Iva5858/juan_learns_to_walk/juan/assets/lm2596_regulator__5.stl

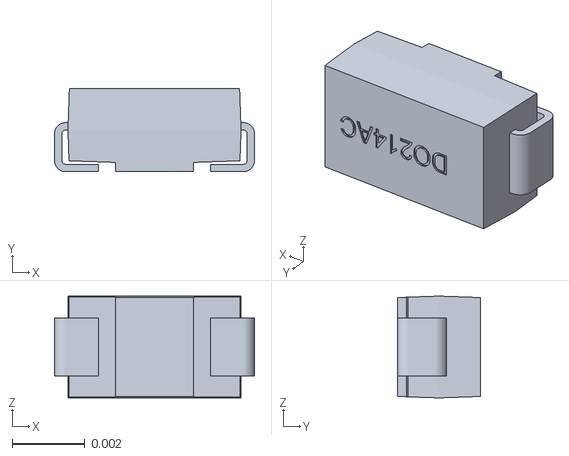
[picture p1: CAD file, 2026-10-11]
juan/assets/lm2596_regulator__5.stl
0.00549 x 0.00229 x 0.00279
