Iva5858/juan_learns_to_walk/juan/assets/9_head_cover.stl

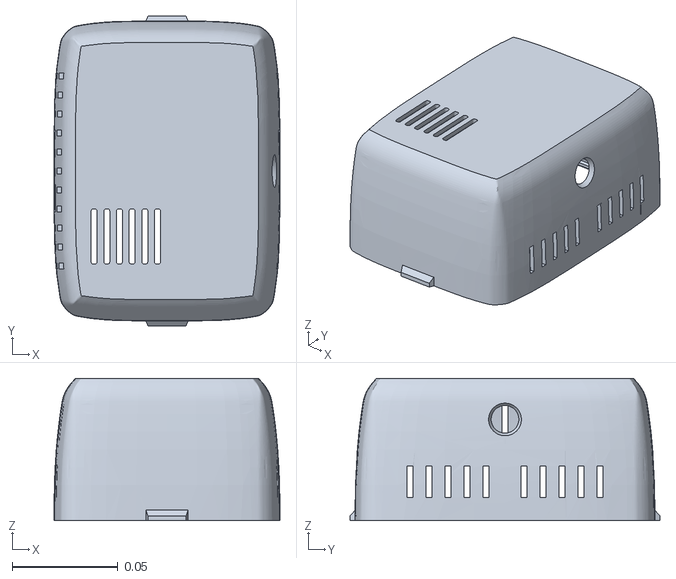
[picture p2: CAD file, 2026-10-11]
juan/assets/9_head_cover.stl
0.107 x 0.147 x 0.0674
