Iva5858/juan_learns_to_walk/juan/assets/adafruit_bno055_imu__81.stl

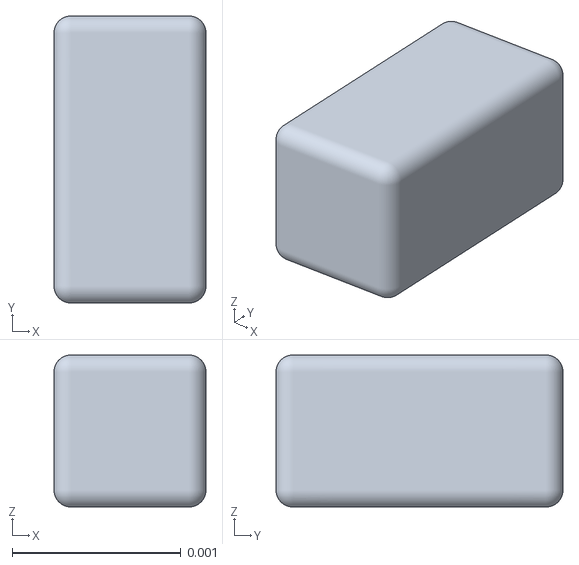
[picture p3: CAD file, 2026-10-11]
juan/assets/adafruit_bno055_imu__81.stl
0.0009 x 0.0017 x 0.0009
