Iva5858/juan_learns_to_walk/juan/assets/lm2596_regulator__13.stl

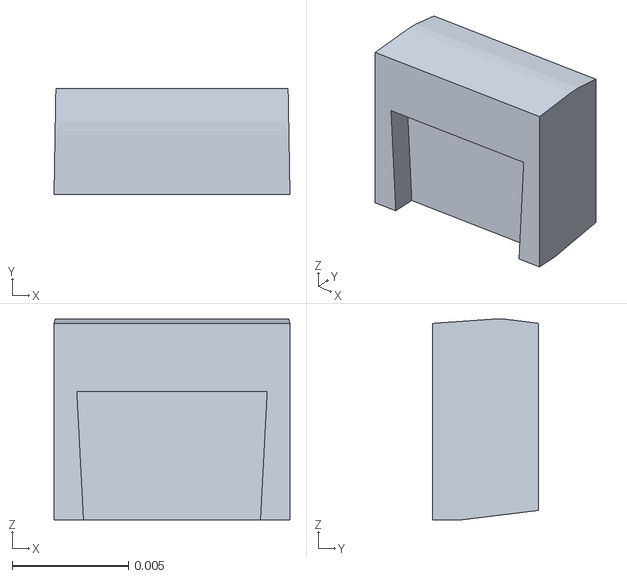
[picture p4: CAD file, 2026-10-11]
juan/assets/lm2596_regulator__13.stl
0.0102 x 0.00455 x 0.00863
