Iva5858/juan_learns_to_walk/juan/assets/1b_hip_outboard.stl

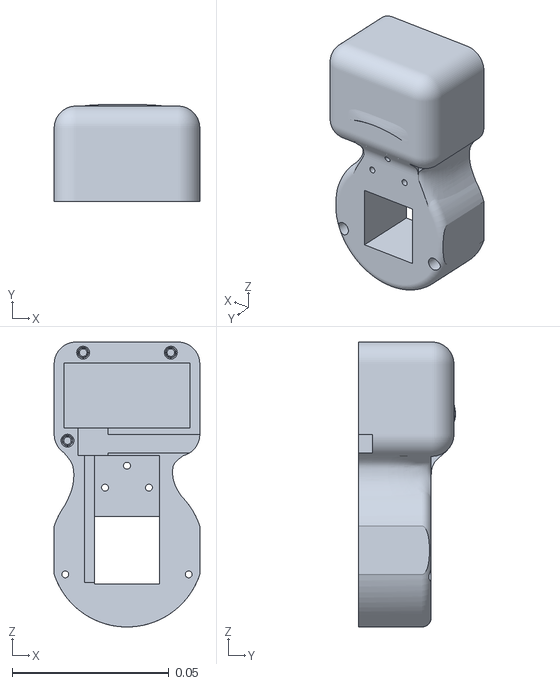
[picture p5: CAD file, 2026-10-11]
juan/assets/1b_hip_outboard.stl
0.0465 x 0.031 x 0.091
