Iva5858/juan_learns_to_walk/juan/assets/lm2596_regulator__24.stl

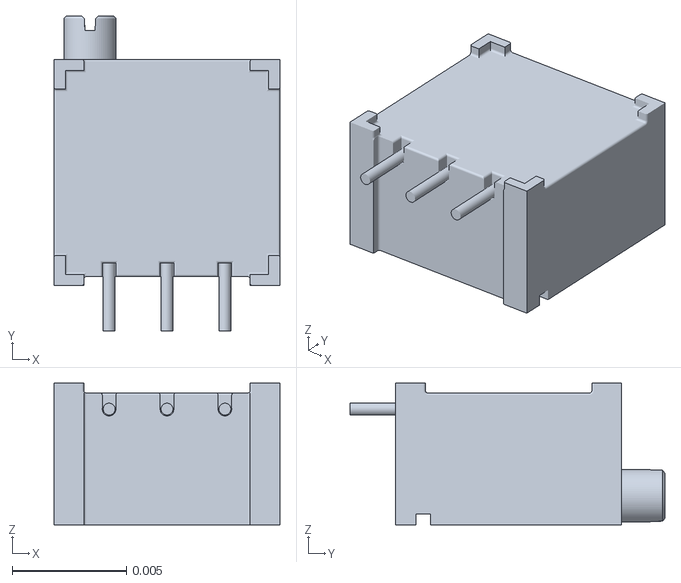
[picture p6: CAD file, 2026-10-11]
juan/assets/lm2596_regulator__24.stl
0.00991 x 0.0138 x 0.00622
