Iva5858/juan_learns_to_walk/juan/assets/adafruit_bno055_imu__9.stl

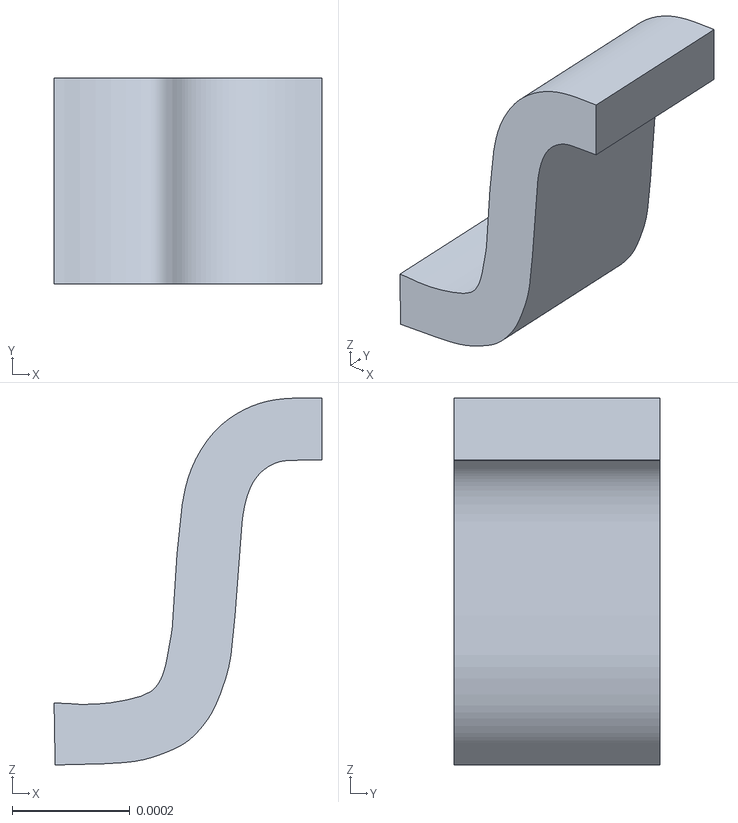
[picture p7: CAD file, 2026-10-11]
juan/assets/adafruit_bno055_imu__9.stl
0.000455 x 0.00035 x 0.000623
