Iva5858/juan_learns_to_walk/juan/assets/adafruit_bno055_imu__4.stl

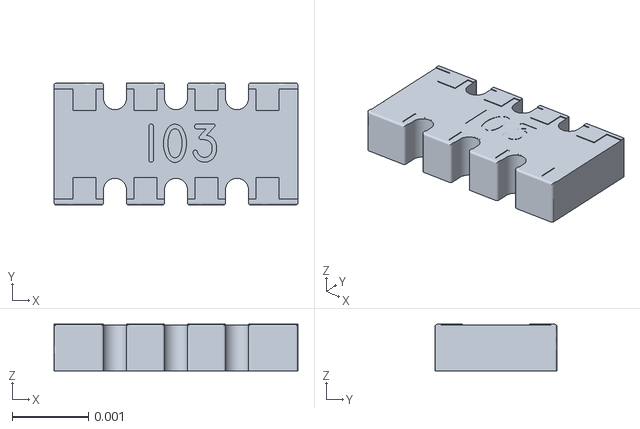
[picture p8: CAD file, 2026-10-11]
juan/assets/adafruit_bno055_imu__4.stl
0.0032 x 0.0016 x 0.00061
