Iva5858/juan_learns_to_walk/juan/assets/usb_cable__debug_board_to_pi.stl

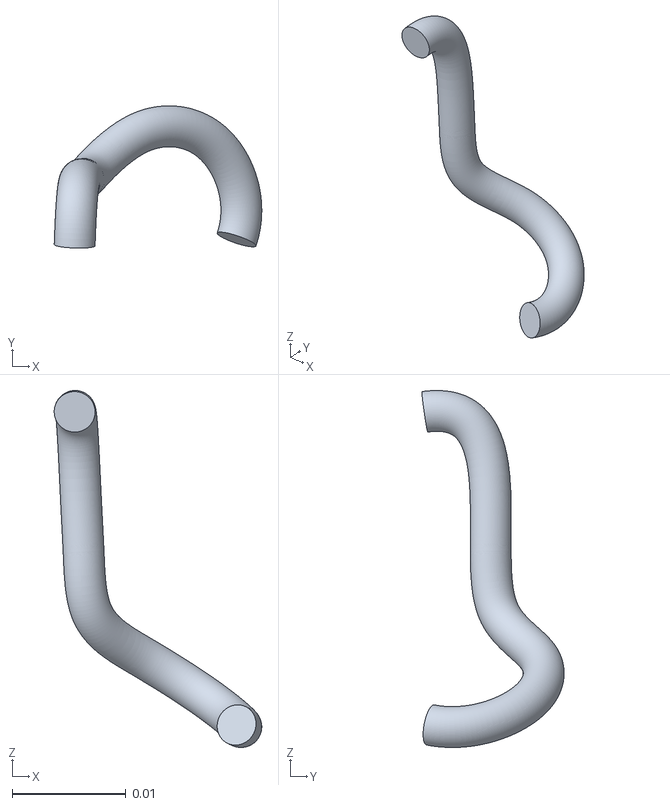
[picture p9: CAD file, 2026-10-11]
juan/assets/usb_cable__debug_board_to_pi.stl
0.0183 x 0.0125 x 0.0314
