Iva5858/juan_learns_to_walk/juan/assets/adafruit_bno055_imu__66.stl

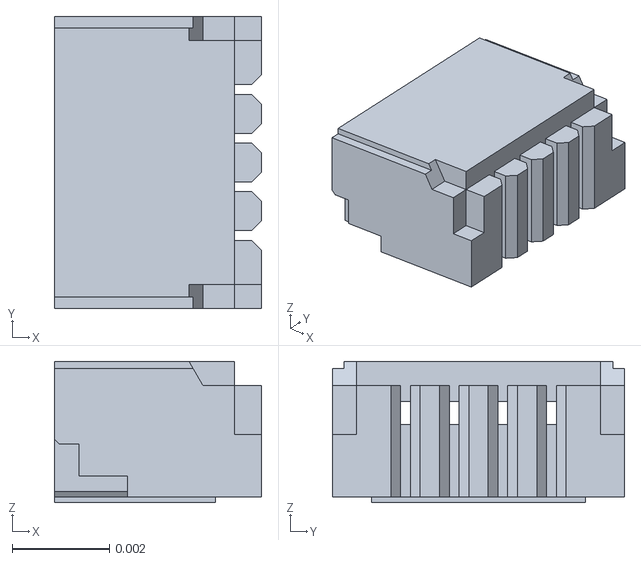
[picture p10: CAD file, 2026-10-11]
juan/assets/adafruit_bno055_imu__66.stl
0.00425 x 0.006 x 0.0029
