Iva5858/juan_learns_to_walk/juan/assets/adafruit_bno055_imu__71.stl

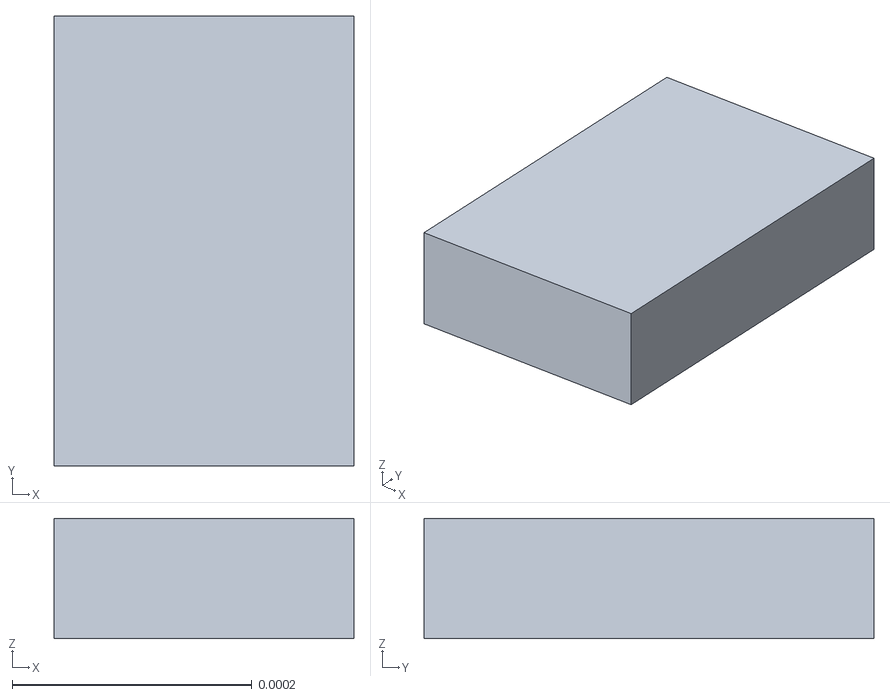
[picture p11: CAD file, 2026-10-11]
juan/assets/adafruit_bno055_imu__71.stl
0.00025 x 0.000375 x 0.0001
