Iva5858/juan_learns_to_walk/juan/assets/adafruit_bno055_imu__27.stl

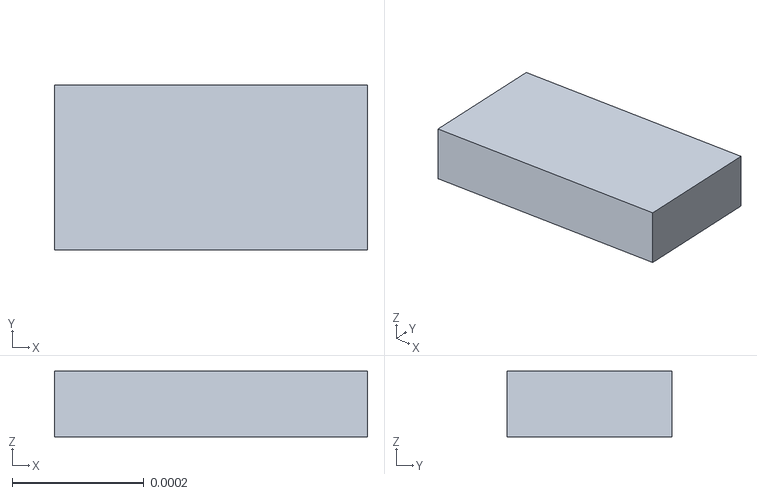
[picture p13: CAD file, 2026-10-11]
juan/assets/adafruit_bno055_imu__27.stl
0.000475 x 0.00025 x 0.0001
