Iva5858/juan_learns_to_walk/juan/assets/imu_wires_to_the_pi_header__4_wires__drawn_as_one.stl

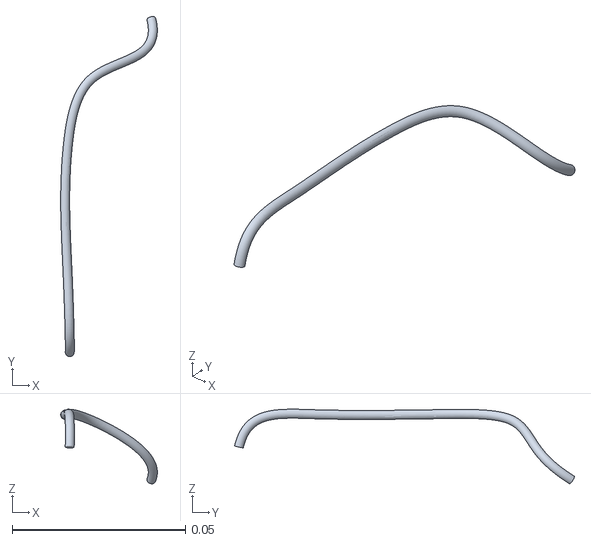
[picture p14: CAD file, 2026-10-11]
juan/assets/imu_wires_to_the_pi_header__4_wires__drawn_as_one.stl
0.0279 x 0.098 x 0.0215
