Iva5858/juan_learns_to_walk/juan/assets/usb_plug_at_the_debug_board.stl

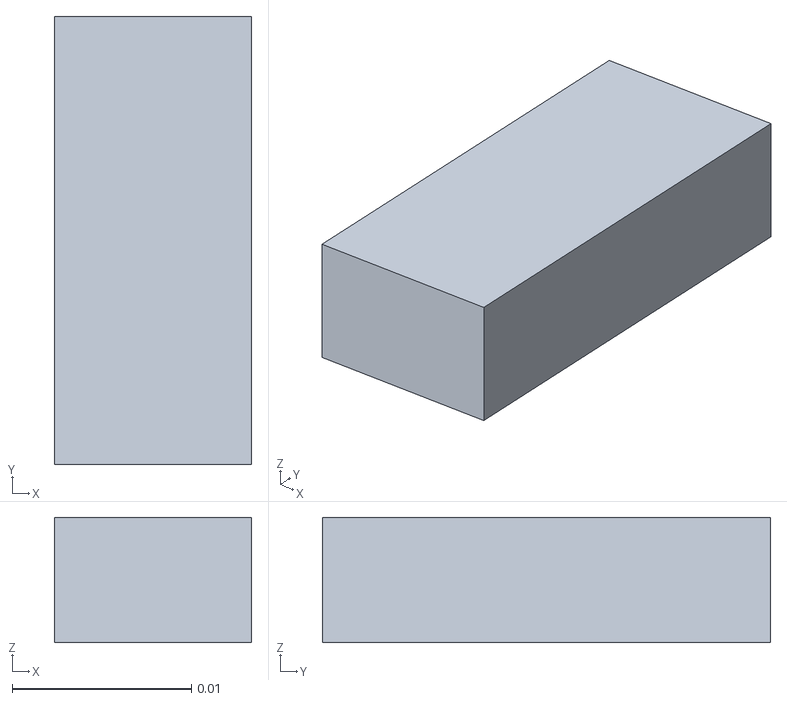
[picture p15: CAD file, 2026-10-11]
juan/assets/usb_plug_at_the_debug_board.stl
0.011 x 0.025 x 0.007
