Iva5858/juan_learns_to_walk/juan/assets/adafruit_bno055_imu__70.stl

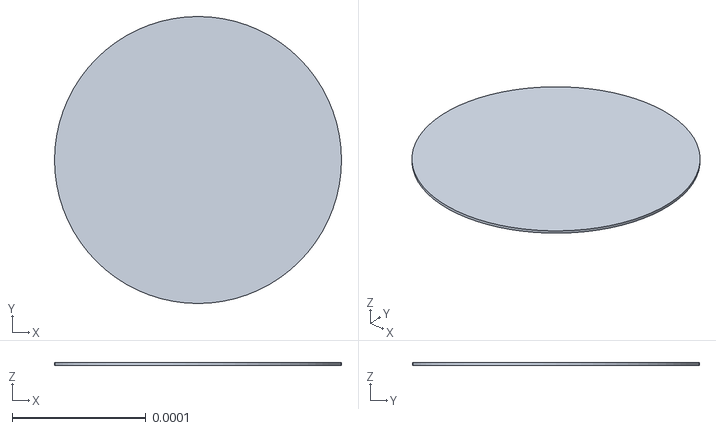
[picture p16: CAD file, 2026-10-11]
juan/assets/adafruit_bno055_imu__70.stl
0.000214 x 0.000214 x 2e-06
