Iva5858/juan_learns_to_walk/juan/assets/3b_shin_outboard_mirrored.stl

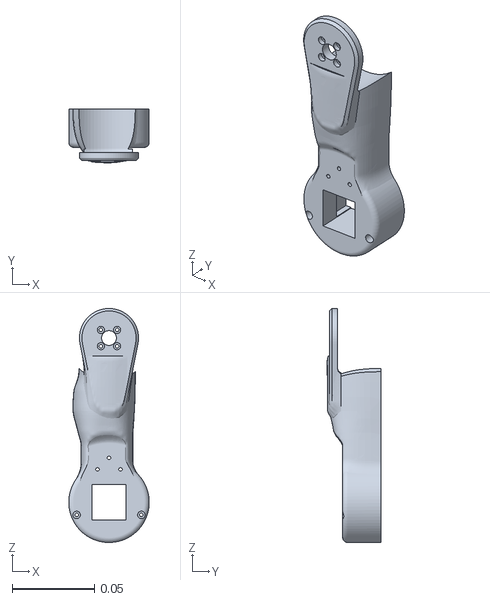
[picture p17: CAD file, 2026-10-11]
juan/assets/3b_shin_outboard_mirrored.stl
0.049 x 0.0327 x 0.142
