Iva5858/juan_learns_to_walk/juan/assets/3a_shin_inboard.stl

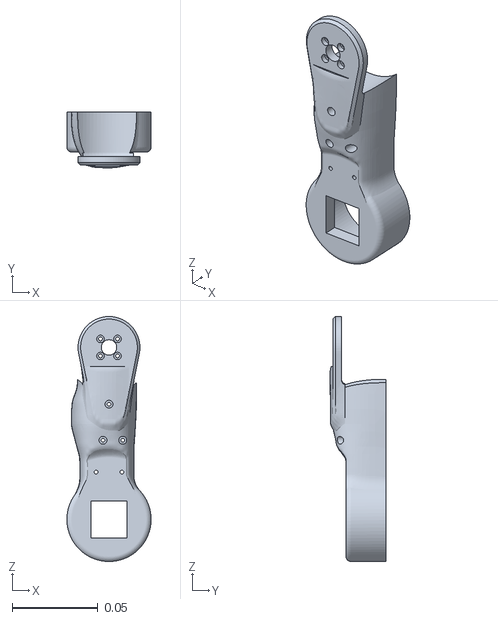
[picture p18: CAD file, 2026-10-11]
juan/assets/3a_shin_inboard.stl
0.049 x 0.0324 x 0.142
