Iva5858/juan_learns_to_walk/juan/assets/adafruit_bno055_imu__72.stl

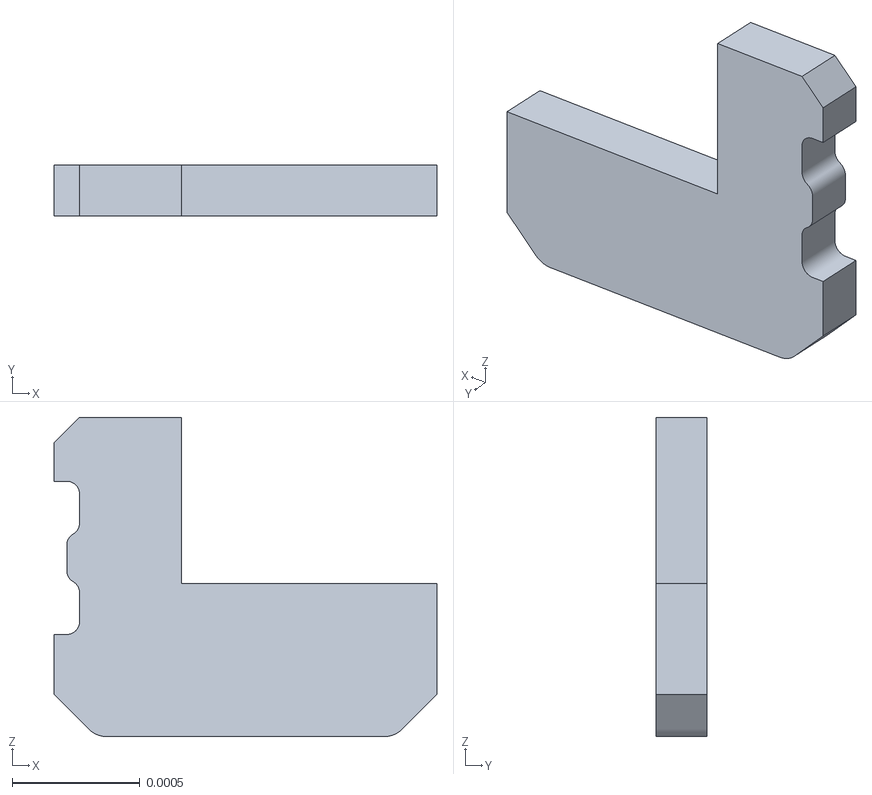
[picture p19: CAD file, 2026-10-11]
juan/assets/adafruit_bno055_imu__72.stl
0.0015 x 0.0002 x 0.00125
