Iva5858/juan_learns_to_walk/juan/assets/adafruit_bno055_imu__52.stl

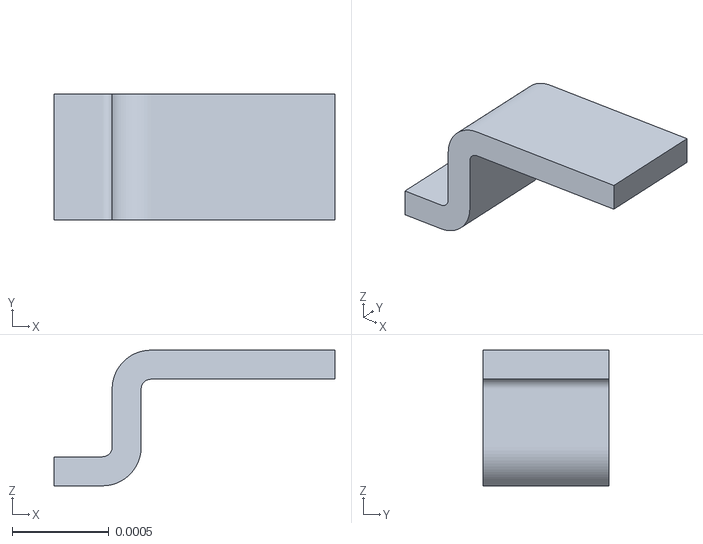
[picture p20: CAD file, 2026-10-11]
juan/assets/adafruit_bno055_imu__52.stl
0.00145 x 0.00065 x 0.0007
