Iva5858/juan_learns_to_walk/juan/assets/lead__knee_servo_out_to_the_shin__right.stl

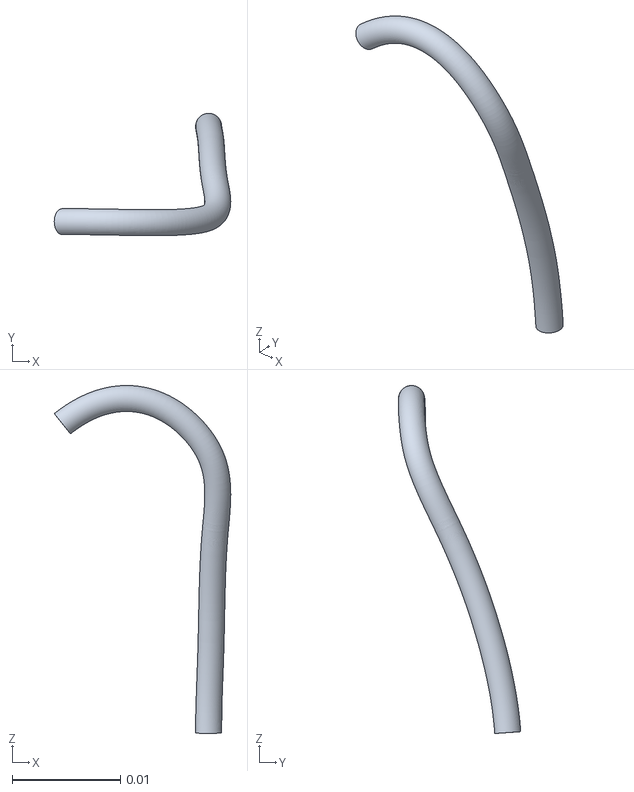
[picture p21: CAD file, 2026-10-11]
juan/assets/lead__knee_servo_out_to_the_shin__right.stl
0.0163 x 0.0113 x 0.0321
