Iva5858/juan_learns_to_walk/juan/assets/adafruit_bno055_imu__77.stl

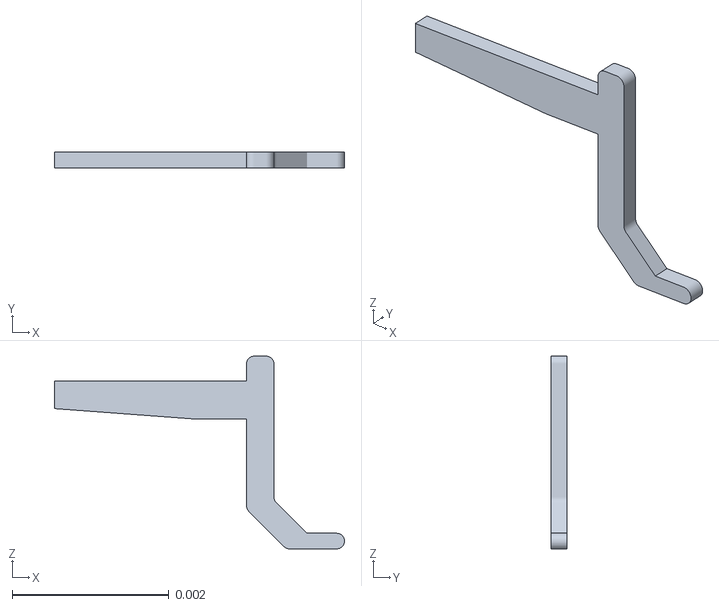
[picture p22: CAD file, 2026-10-11]
juan/assets/adafruit_bno055_imu__77.stl
0.0037 x 0.0002 x 0.00246
