Iva5858/juan_learns_to_walk/juan/assets/adafruit_bno055_imu__35.stl

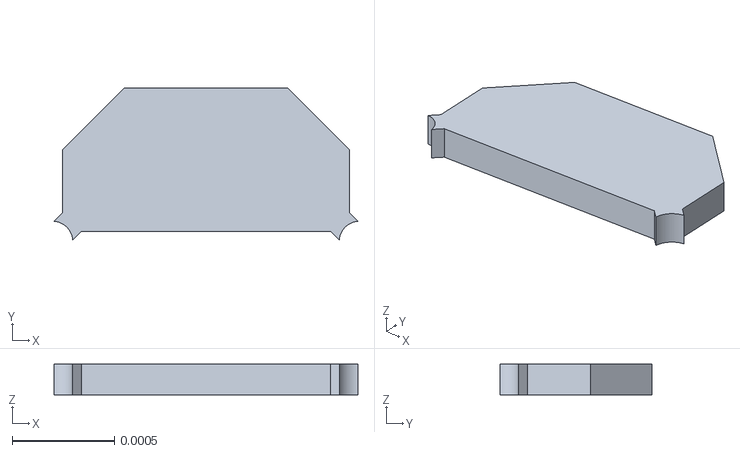
[picture p23: CAD file, 2026-10-11]
juan/assets/adafruit_bno055_imu__35.stl
0.00148 x 0.000742 x 0.00015
