Iva5858/juan_learns_to_walk/juan/assets/lm2596_regulator__10.stl

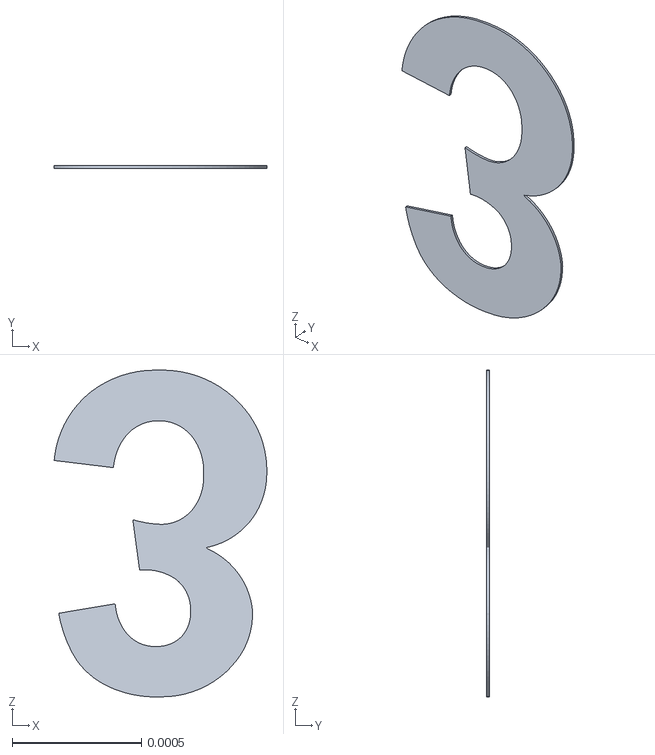
[picture p25: CAD file, 2026-10-11]
juan/assets/lm2596_regulator__10.stl
0.000824 x 1e-05 x 0.00127
