Iva5858/juan_learns_to_walk/juan/assets/servo_bus_lead__right_leg.stl

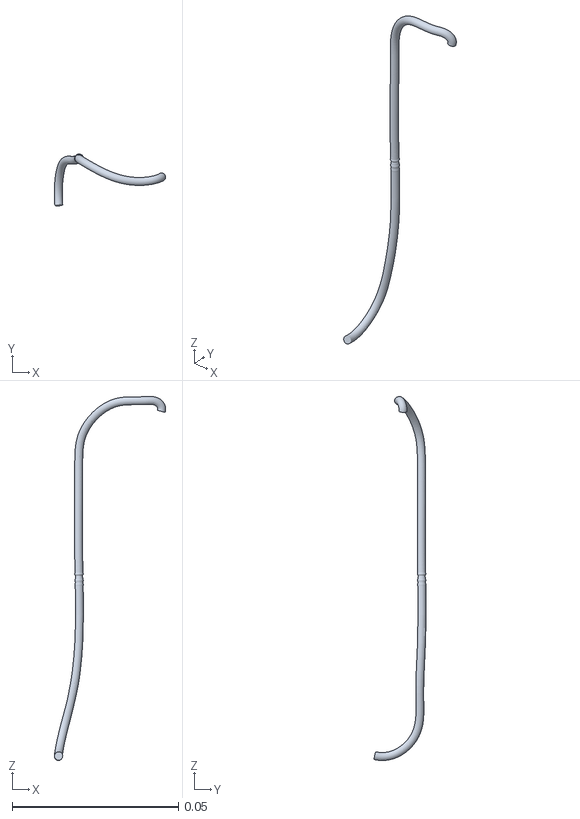
[picture p26: CAD file, 2026-10-11]
juan/assets/servo_bus_lead__right_leg.stl
0.0335 x 0.0156 x 0.11
