Iva5858/juan_learns_to_walk/juan/assets/8_head_shelf.stl

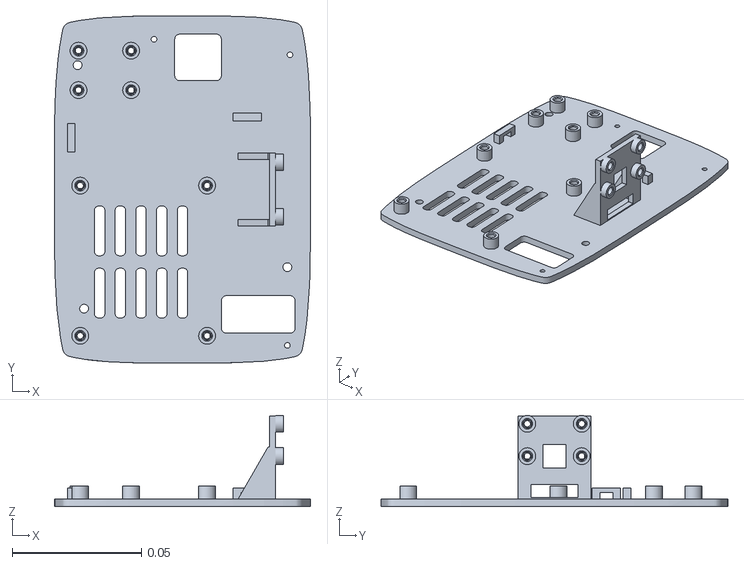
[picture p27: CAD file, 2026-10-11]
juan/assets/8_head_shelf.stl
0.099 x 0.134 x 0.0352
