Iva5858/juan_learns_to_walk/juan/assets/usb_a_plug.stl

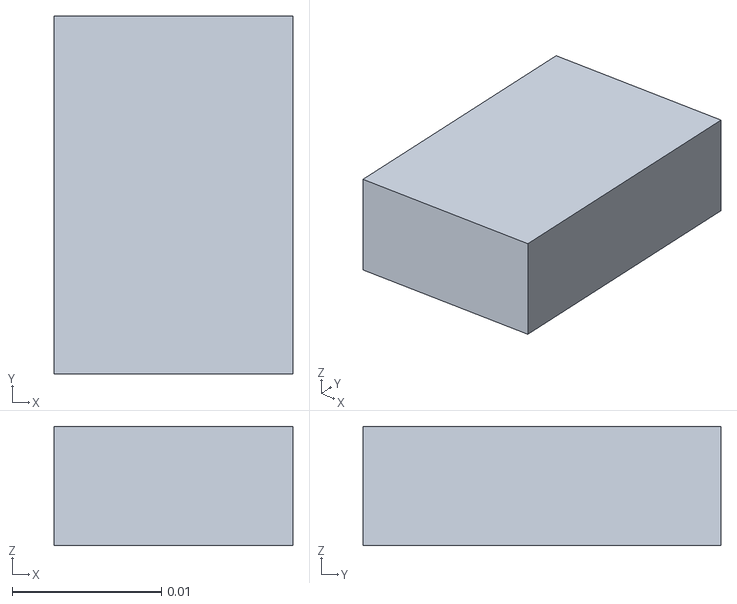
[picture p28: CAD file, 2026-10-11]
juan/assets/usb_a_plug.stl
0.016 x 0.024 x 0.008
