Iva5858/juan_learns_to_walk/juan/assets/lm2596_regulator__8.stl

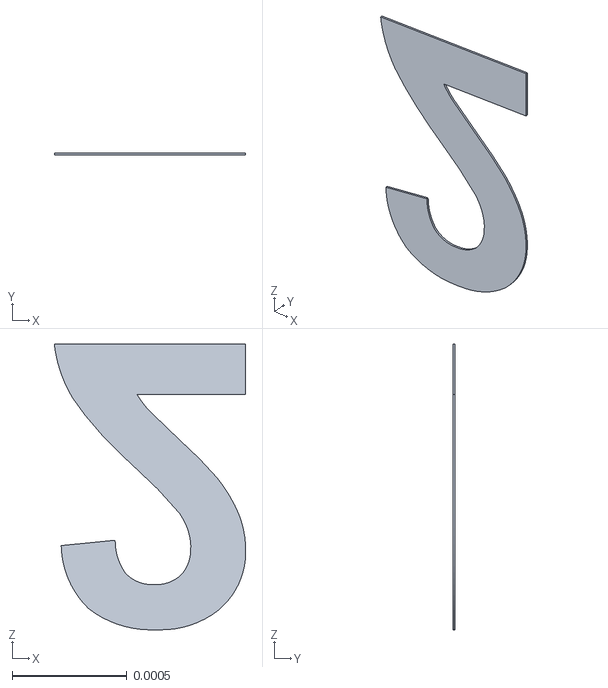
[picture p29: CAD file, 2026-10-11]
juan/assets/lm2596_regulator__8.stl
0.000834 x 1e-05 x 0.00125
