Iva5858/juan_learns_to_walk/juan/assets/servo_socket_b.stl

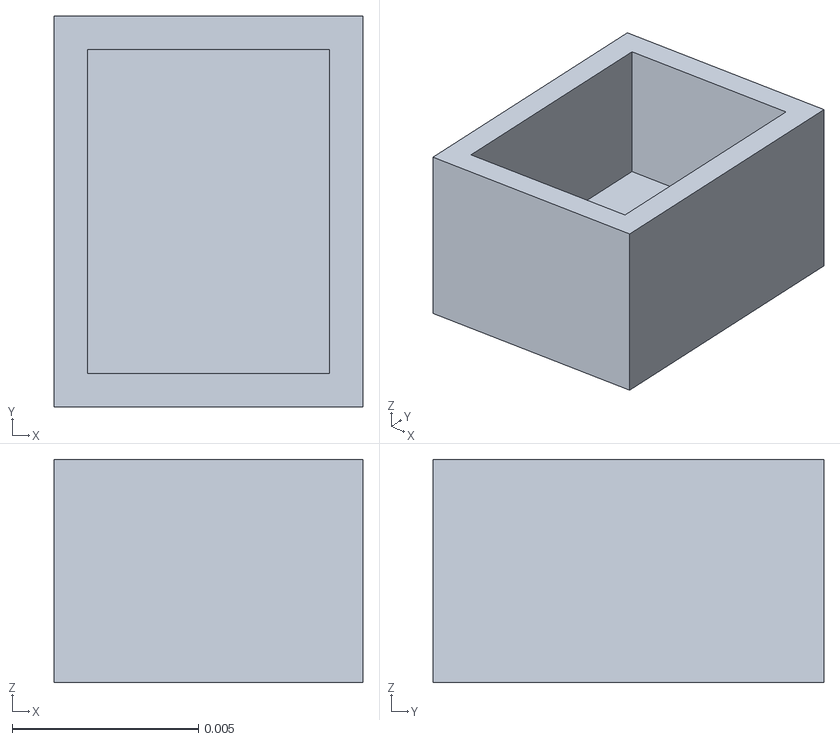
[picture p30: CAD file, 2026-10-11]
juan/assets/servo_socket_b.stl
0.0083 x 0.0105 x 0.006
