Iva5858/juan_learns_to_walk/juan/assets/lead__roll_servo_to_hip_pitch_servo__left.stl

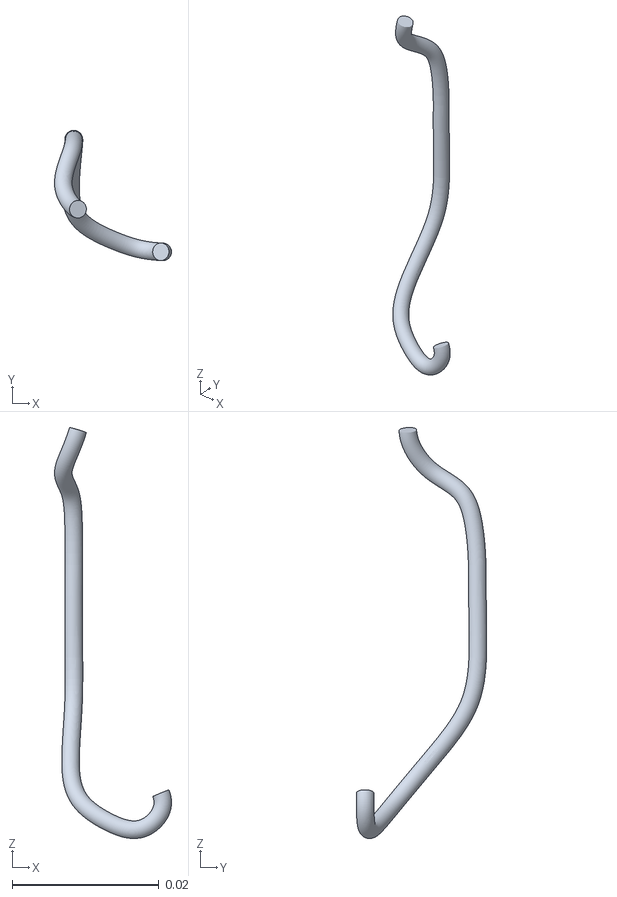
[picture p31: CAD file, 2026-10-11]
juan/assets/lead__roll_servo_to_hip_pitch_servo__left.stl
0.016 x 0.0178 x 0.056
