Iva5858/juan_learns_to_walk/juan/assets/lm2596_regulator__18.stl

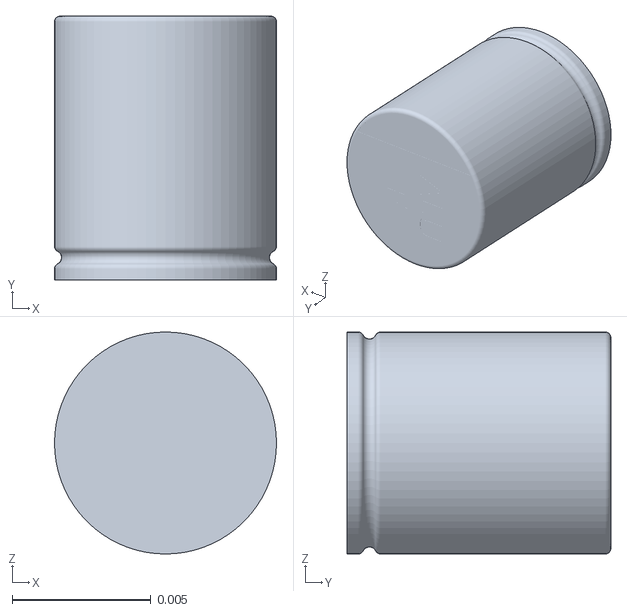
[picture p32: CAD file, 2026-10-11]
juan/assets/lm2596_regulator__18.stl
0.008 x 0.0095 x 0.008
