Iva5858/juan_learns_to_walk/juan/assets/lm2596_regulator__3.stl

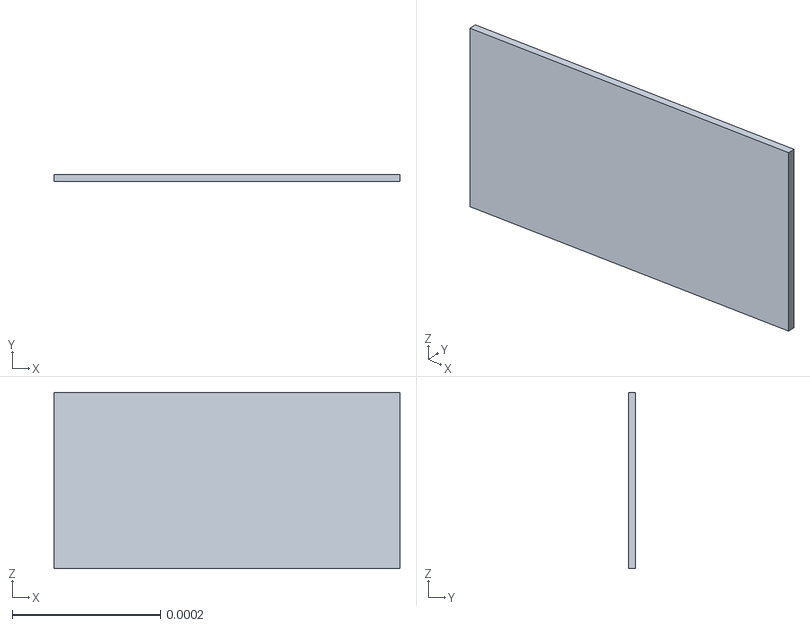
[picture p33: CAD file, 2026-10-11]
juan/assets/lm2596_regulator__3.stl
0.000467 x 1e-05 x 0.000238
