Iva5858/juan_learns_to_walk/juan/assets/lm2596_regulator__15.stl

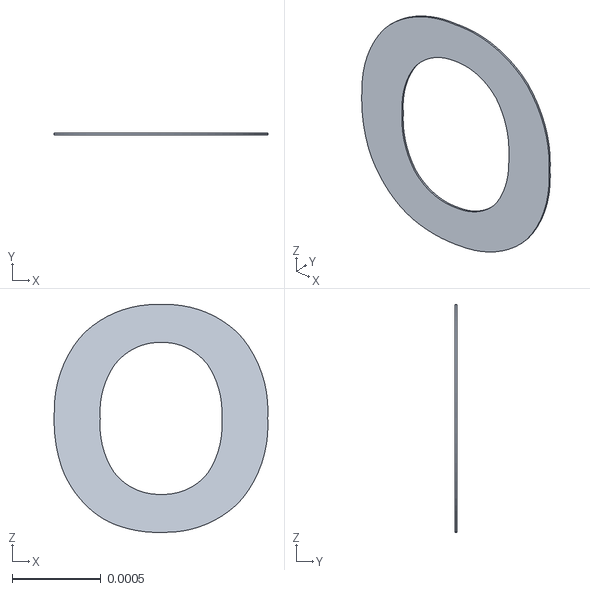
[picture p34: CAD file, 2026-10-11]
juan/assets/lm2596_regulator__15.stl
0.0012 x 1e-05 x 0.00128
