Iva5858/juan_learns_to_walk/juan/assets/adafruit_bno055_imu__69.stl

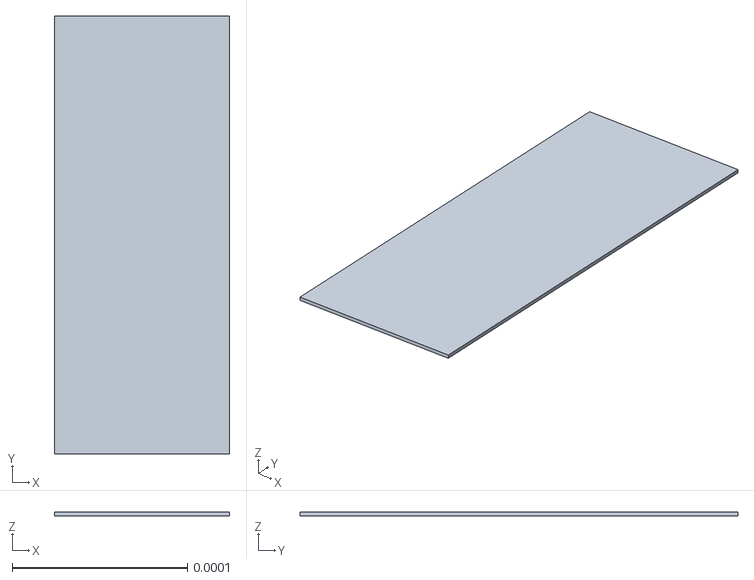
[picture p35: CAD file, 2026-10-11]
juan/assets/adafruit_bno055_imu__69.stl
0.0001 x 0.00025 x 2e-06
