Iva5858/juan_learns_to_walk/juan/assets/servo_plug_b.stl

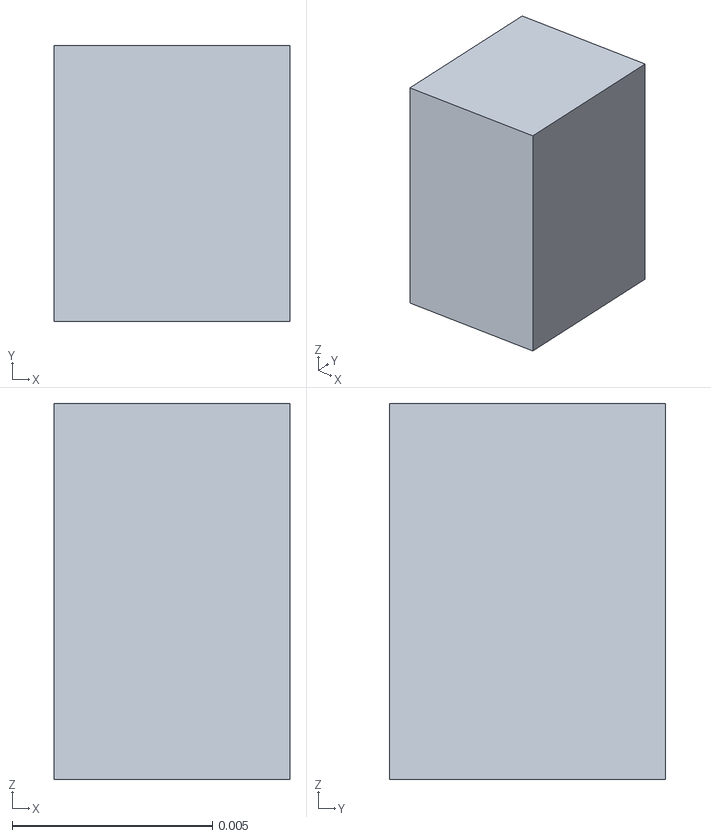
[picture p36: CAD file, 2026-10-11]
juan/assets/servo_plug_b.stl
0.0059 x 0.0069 x 0.0094
