Iva5858/juan_learns_to_walk/juan/assets/htd_35h_horn.stl

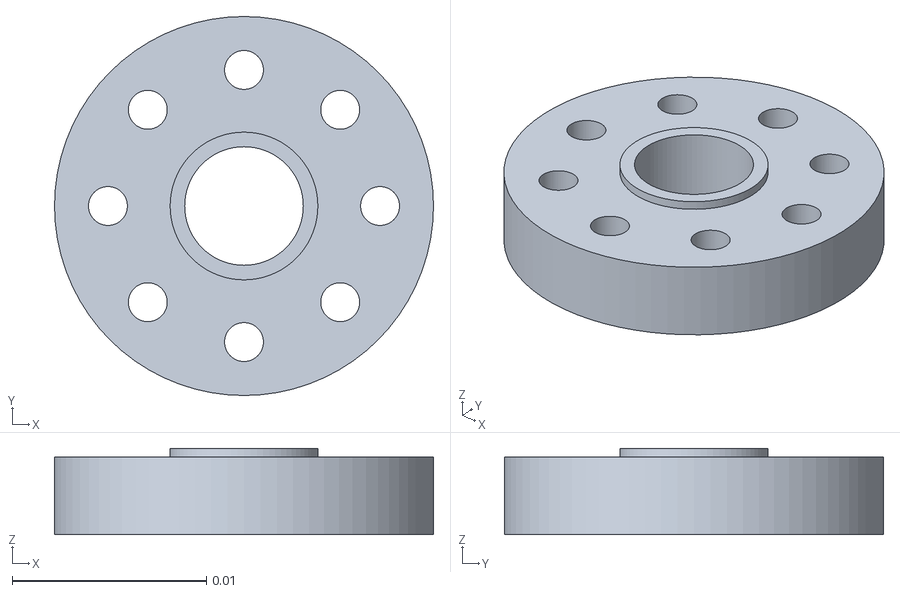
[picture p37: CAD file, 2026-10-11]
juan/assets/htd_35h_horn.stl
0.0195 x 0.0195 x 0.00445
