Iva5858/juan_learns_to_walk/juan/assets/2b_thigh_outboard.stl

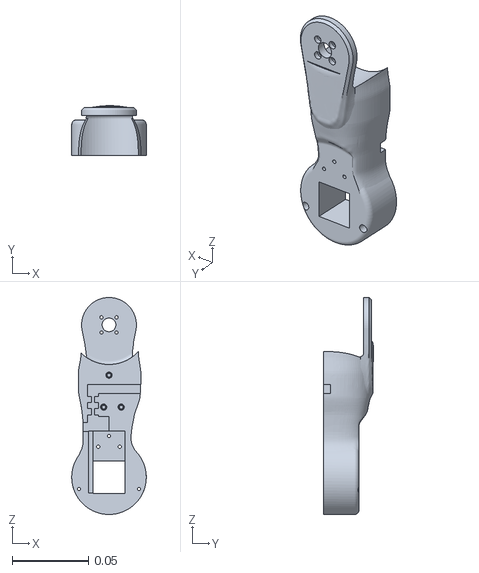
[picture p38: CAD file, 2026-10-11]
juan/assets/2b_thigh_outboard.stl
0.049 x 0.0326 x 0.142
