Iva5858/juan_learns_to_walk/juan/assets/adafruit_bno055_imu.stl

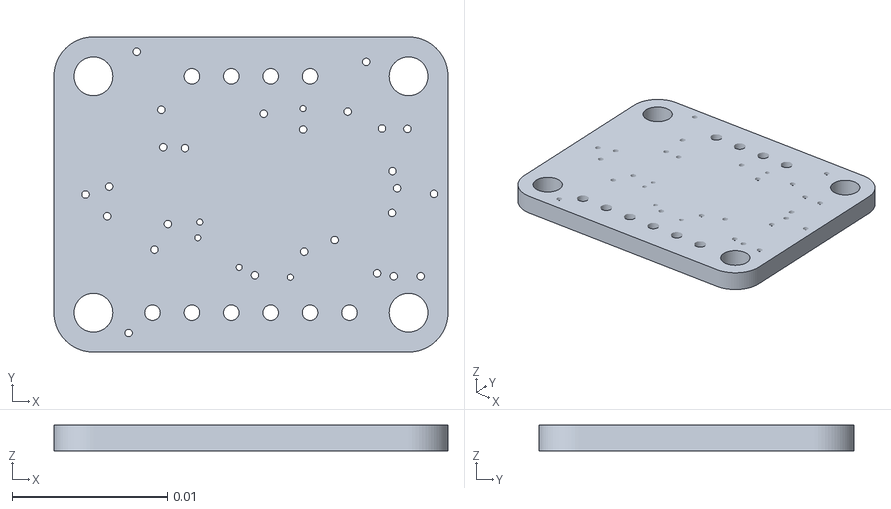
[picture p39: CAD file, 2026-10-11]
juan/assets/adafruit_bno055_imu.stl
0.0254 x 0.0203 x 0.00165
