Iva5858/juan_learns_to_walk/juan/assets/lm2596_regulator__9.stl

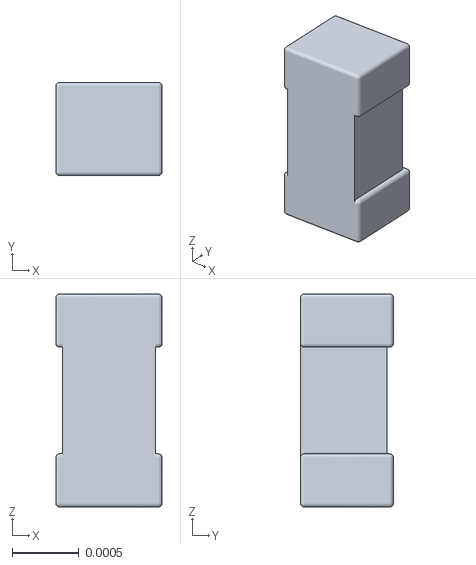
[picture p40: CAD file, 2026-10-11]
juan/assets/lm2596_regulator__9.stl
0.0008 x 0.0007 x 0.0016
