Iva5858/juan_learns_to_walk/juan/assets/adafruit_bno055_imu__68.stl

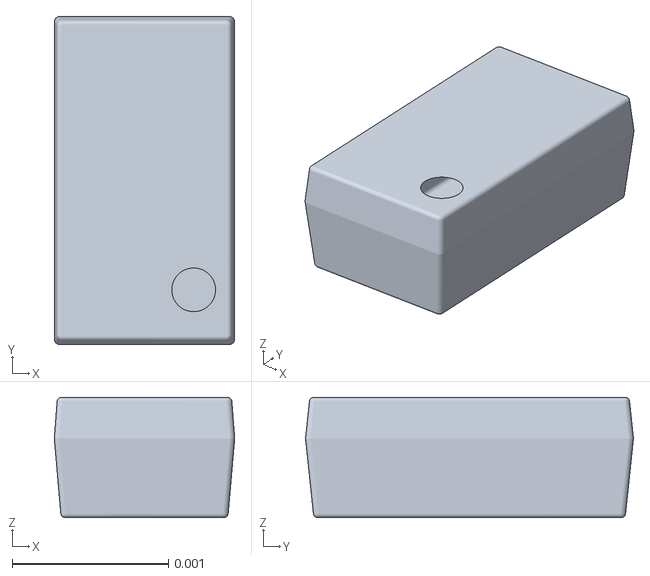
[picture p41: CAD file, 2026-10-11]
juan/assets/adafruit_bno055_imu__68.stl
0.00116 x 0.0021 x 0.00077
