Iva5858/juan_learns_to_walk/juan/assets/adafruit_bno055_imu__39.stl

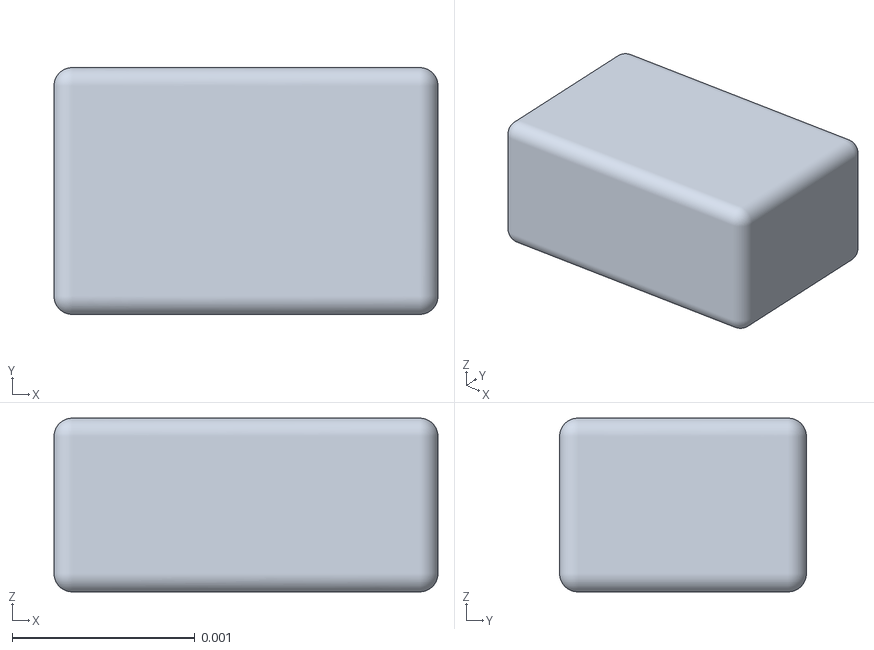
[picture p43: CAD file, 2026-10-11]
juan/assets/adafruit_bno055_imu__39.stl
0.0021 x 0.00135 x 0.00095
