Iva5858/juan_learns_to_walk/juan/assets/lead__hip_pitch_servo_out_to_the_thigh__right.stl

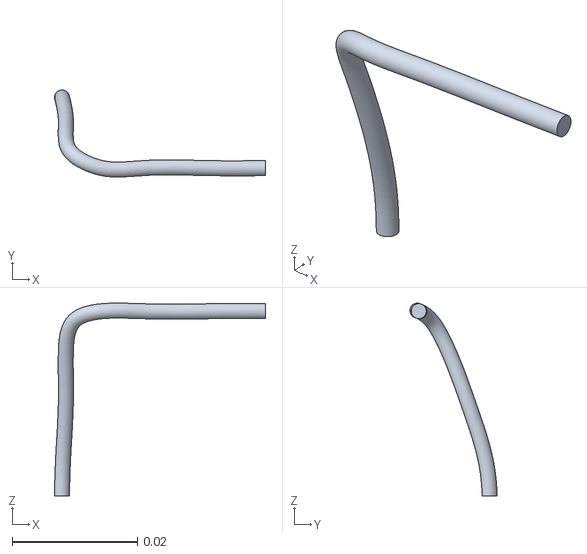
[picture p44: CAD file, 2026-10-11]
juan/assets/lead__hip_pitch_servo_out_to_the_thigh__right.stl
0.0337 x 0.0139 x 0.0308
