Iva5858/juan_learns_to_walk/juan/assets/lead_in_from_the_hip_to_the_knee_servo__left.stl

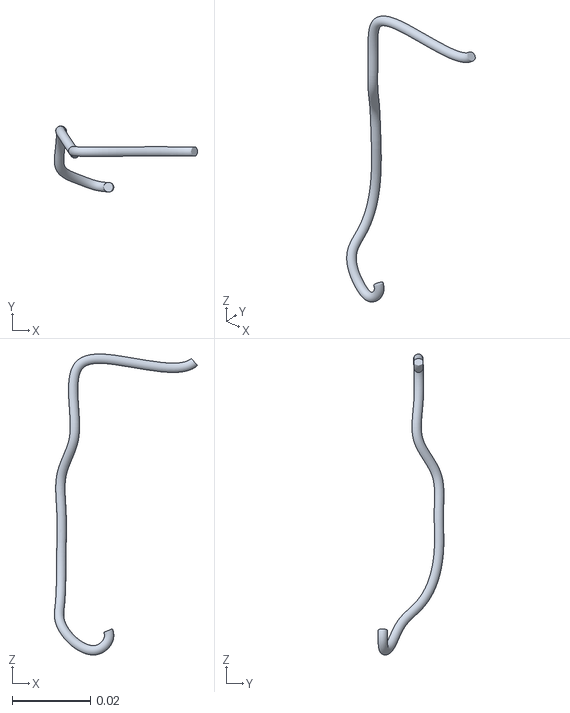
[picture p45: CAD file, 2026-10-11]
juan/assets/lead_in_from_the_hip_to_the_knee_servo__left.stl
0.0365 x 0.0168 x 0.0767
