Iva5858/juan_learns_to_walk/juan/assets/lm2596_regulator__14.stl

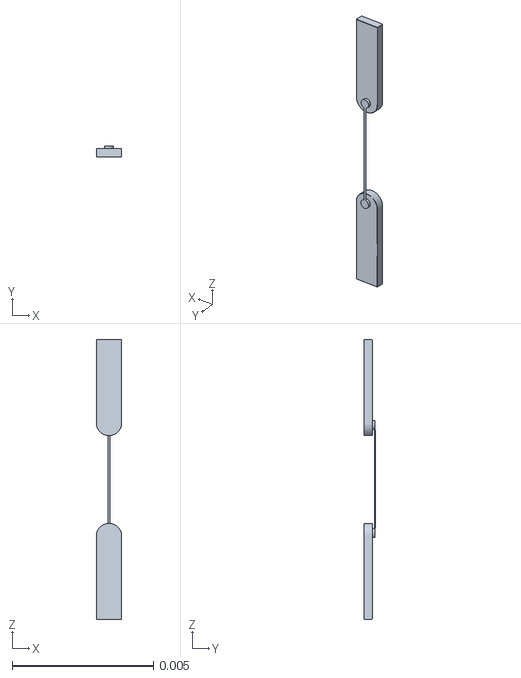
[picture p46: CAD file, 2026-10-11]
juan/assets/lm2596_regulator__14.stl
0.0009 x 0.0004 x 0.0099
