Iva5858/juan_learns_to_walk/juan/assets/4_ankle_foot.stl

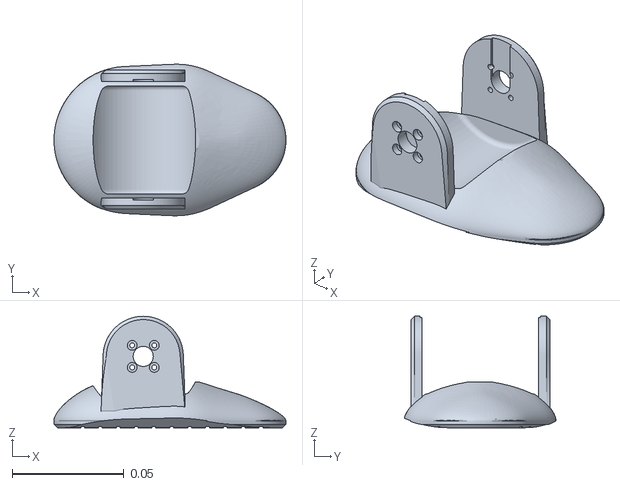
[picture p47: CAD file, 2026-10-11]
juan/assets/4_ankle_foot.stl
0.104 x 0.0679 x 0.05
