Iva5858/juan_learns_to_walk/juan/assets/adafruit_bno055_imu__12.stl

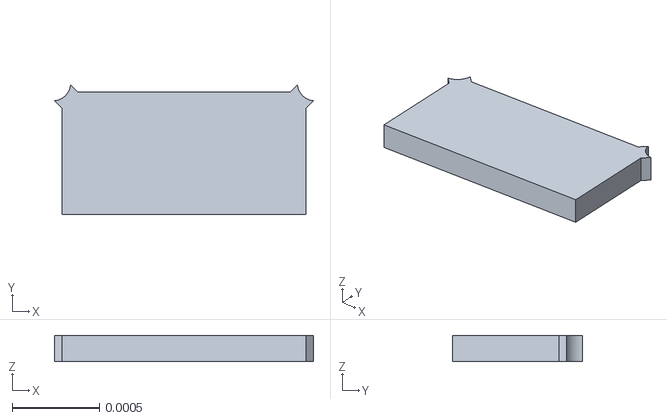
[picture p48: CAD file, 2026-10-11]
juan/assets/adafruit_bno055_imu__12.stl
0.00148 x 0.000742 x 0.00015
