Iva5858/juan_learns_to_walk/juan/assets/lm2596_regulator__12.stl

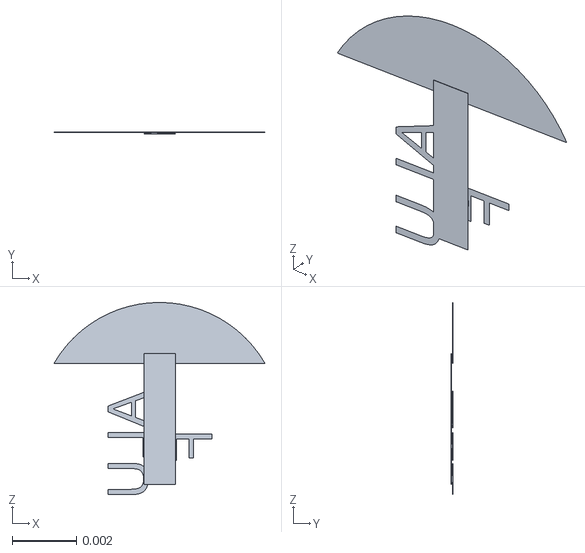
[picture p49: CAD file, 2026-10-11]
juan/assets/lm2596_regulator__12.stl
0.00658 x 6e-05 x 0.00599
