Iva5858/juan_learns_to_walk/juan/assets/adafruit_bno055_imu__56.stl

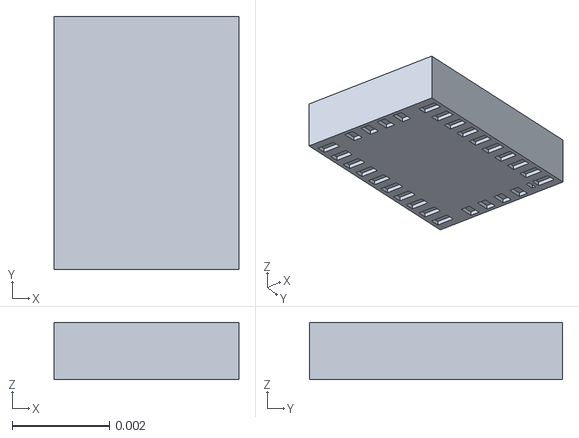
[picture p50: CAD file, 2026-10-11]
juan/assets/adafruit_bno055_imu__56.stl
0.0038 x 0.0052 x 0.00118
