Iva5858/juan_learns_to_walk/juan/assets/adafruit_bno055_imu__21.stl

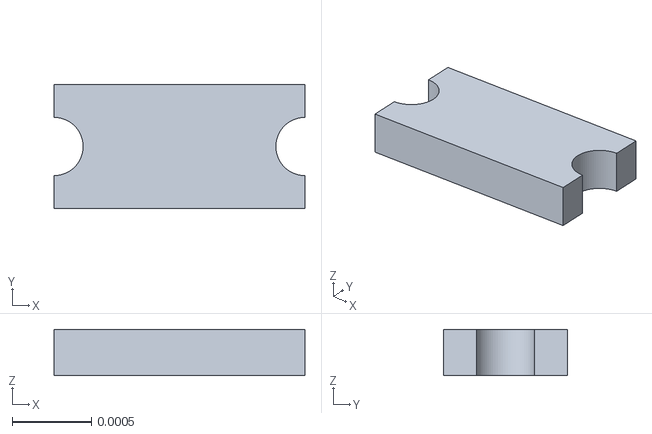
[picture p51: CAD file, 2026-10-11]
juan/assets/adafruit_bno055_imu__21.stl
0.00159 x 0.000787 x 0.000292
