Iva5858/juan_learns_to_walk/juan/assets/adafruit_bno055_imu__82.stl

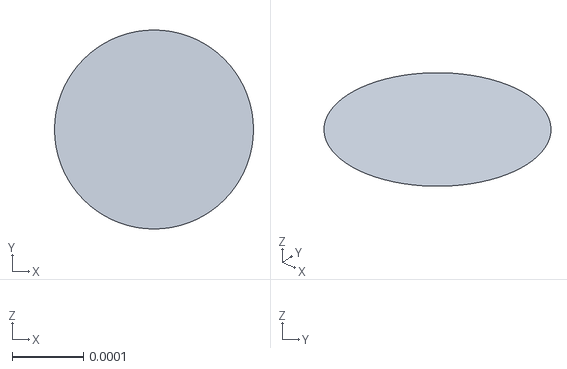
[picture p52: CAD file, 2026-10-11]
juan/assets/adafruit_bno055_imu__82.stl
0.00028 x 0.00028 x 0
