Iva5858/juan_learns_to_walk/juan/assets/adafruit_bno055_imu__5.stl

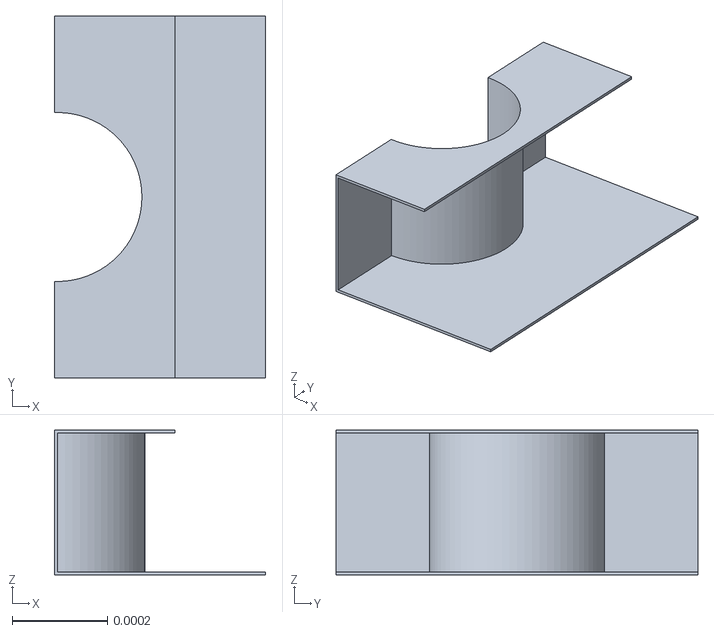
[picture p53: CAD file, 2026-10-11]
juan/assets/adafruit_bno055_imu__5.stl
0.000445 x 0.000762 x 0.000305
