Iva5858/juan_learns_to_walk/juan/assets/adafruit_bno055_imu__51.stl

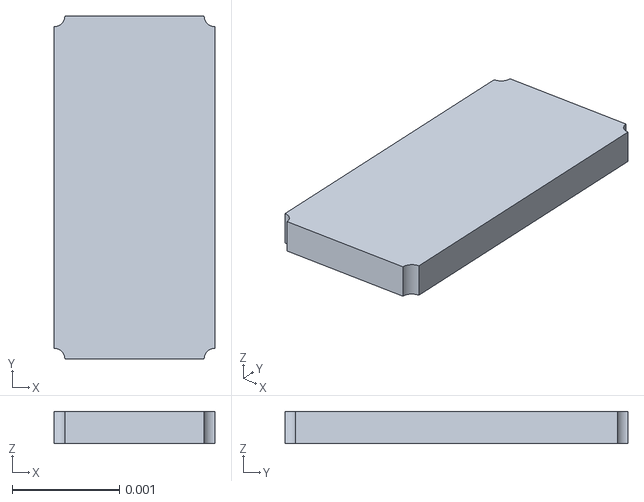
[picture p54: CAD file, 2026-10-11]
juan/assets/adafruit_bno055_imu__51.stl
0.0015 x 0.0032 x 0.0003
