Iva5858/juan_learns_to_walk/juan/assets/adafruit_bno055_imu__29.stl

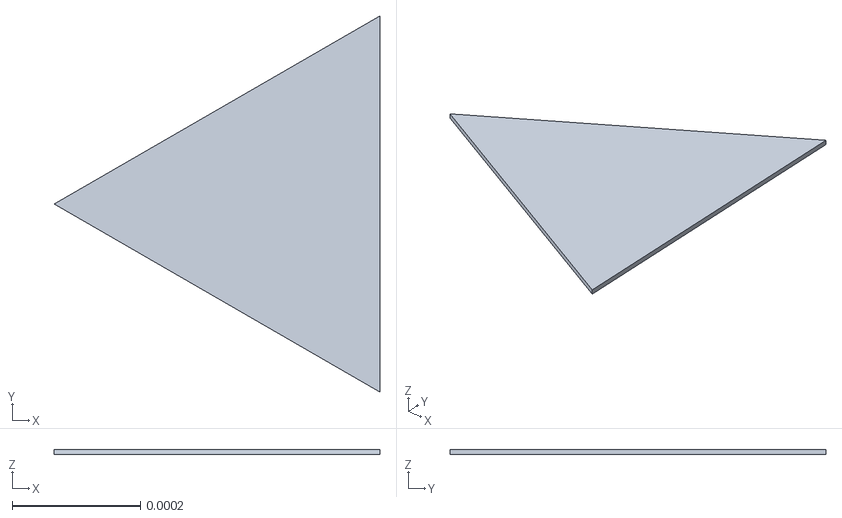
[picture p55: CAD file, 2026-10-11]
juan/assets/adafruit_bno055_imu__29.stl
0.000508 x 0.000587 x 7.62e-06
