Iva5858/juan_learns_to_walk/juan/assets/adafruit_bno055_imu__54.stl

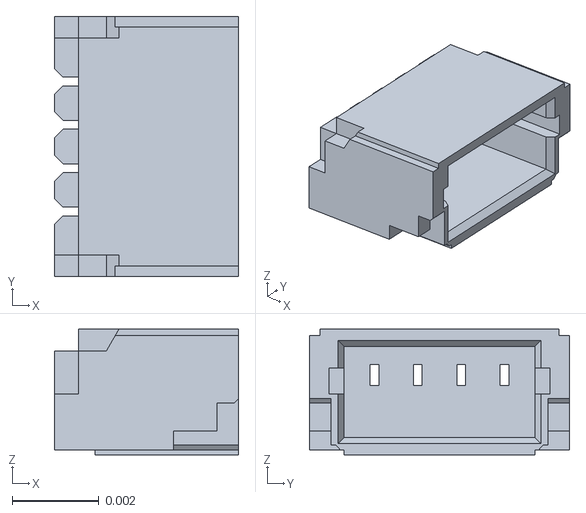
[picture p56: CAD file, 2026-10-11]
juan/assets/adafruit_bno055_imu__54.stl
0.00425 x 0.006 x 0.0029
