Iva5858/juan_learns_to_walk/juan/assets/camera_ribbon__flat_cable__drawn_round.stl

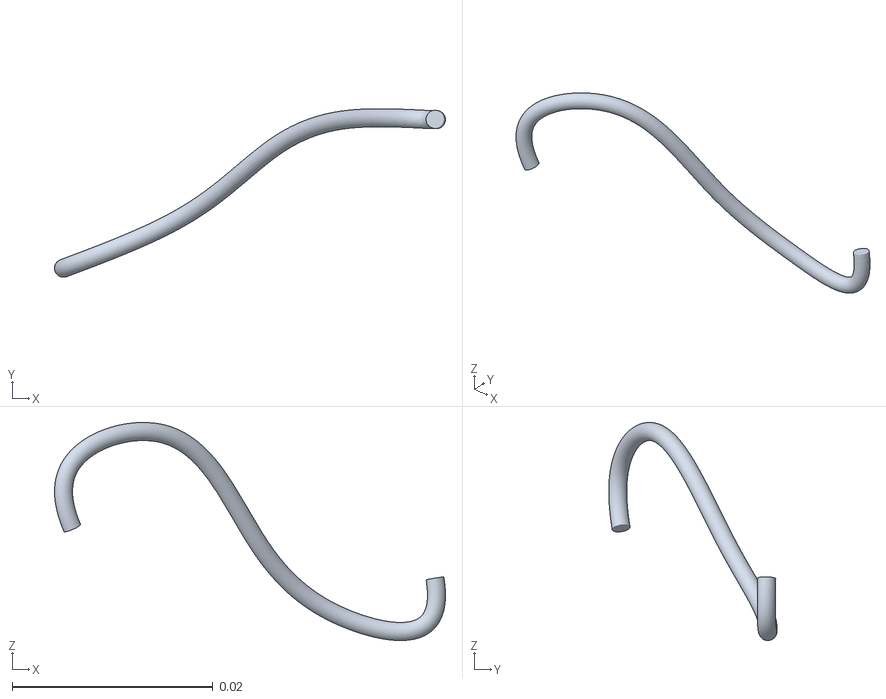
[picture p57: CAD file, 2026-10-11]
juan/assets/camera_ribbon__flat_cable__drawn_round.stl
0.0389 x 0.0168 x 0.0217
