Iva5858/juan_learns_to_walk/juan/assets/battery_3s_2200_mah__motors.stl

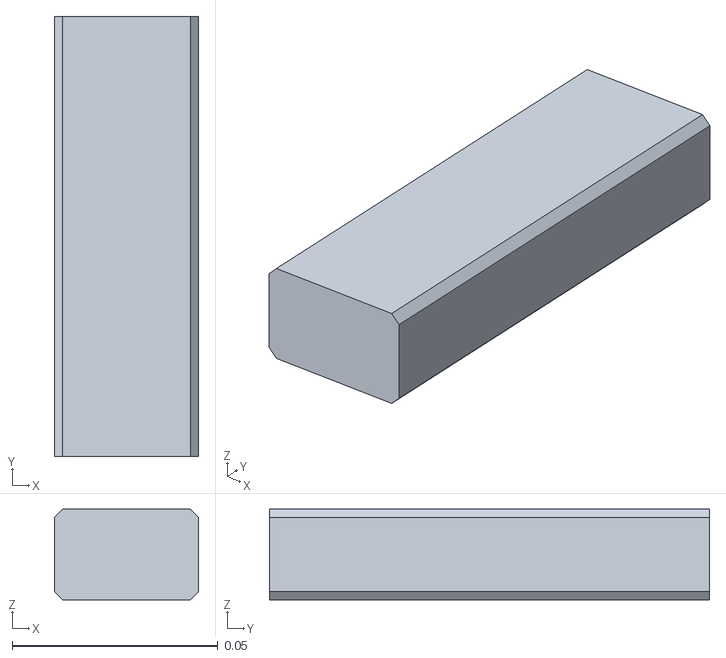
[picture p58: CAD file, 2026-10-11]
juan/assets/battery_3s_2200_mah__motors.stl
0.035 x 0.107 x 0.022
