Iva5858/juan_learns_to_walk/juan/assets/adafruit_bno055_imu__37.stl

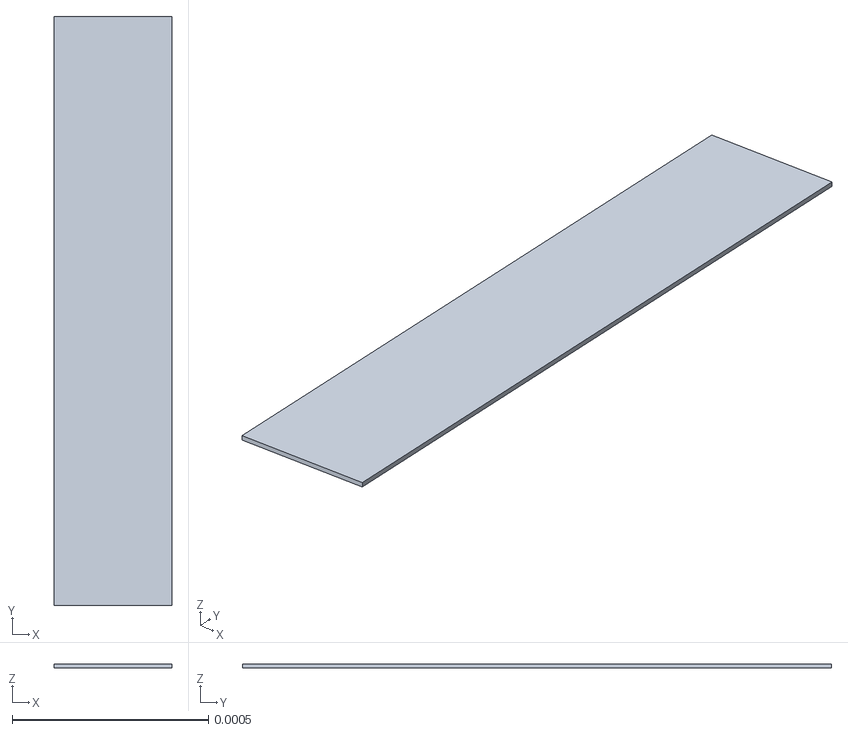
[picture p59: CAD file, 2026-10-11]
juan/assets/adafruit_bno055_imu__37.stl
0.0003 x 0.0015 x 1e-05
