Iva5858/juan_learns_to_walk/juan/assets/lm2596_regulator__2.stl

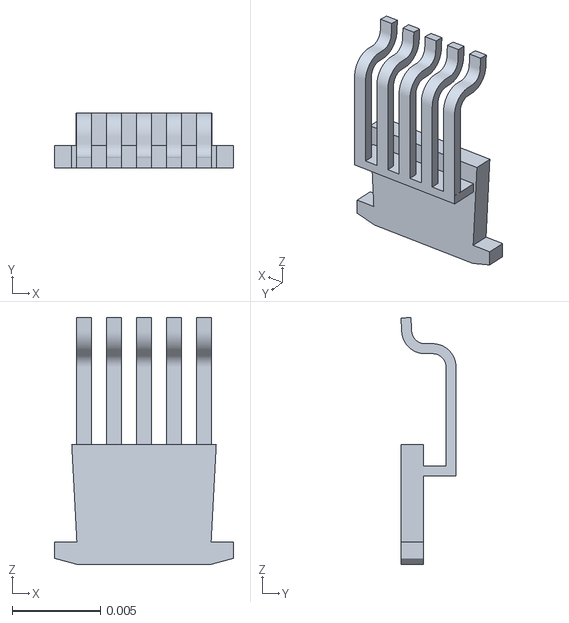
[picture p60: CAD file, 2026-10-11]
juan/assets/lm2596_regulator__2.stl
0.0102 x 0.00313 x 0.014
