Iva5858/juan_learns_to_walk/juan/assets/chip_2.stl

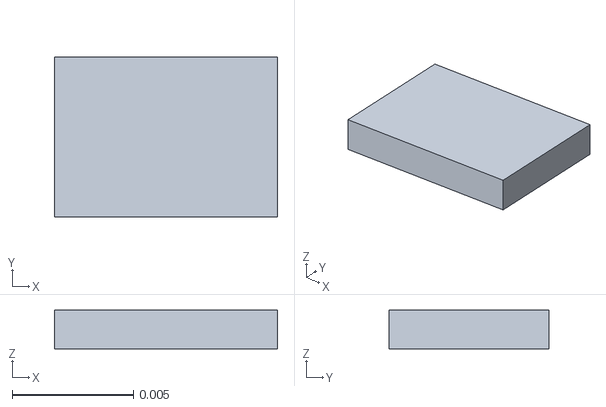
[picture p61: CAD file, 2026-10-11]
juan/assets/chip_2.stl
0.0092 x 0.0066 x 0.0016
