Iva5858/juan_learns_to_walk/juan/assets/usb_c_power_cable__regulator_to_pi.stl

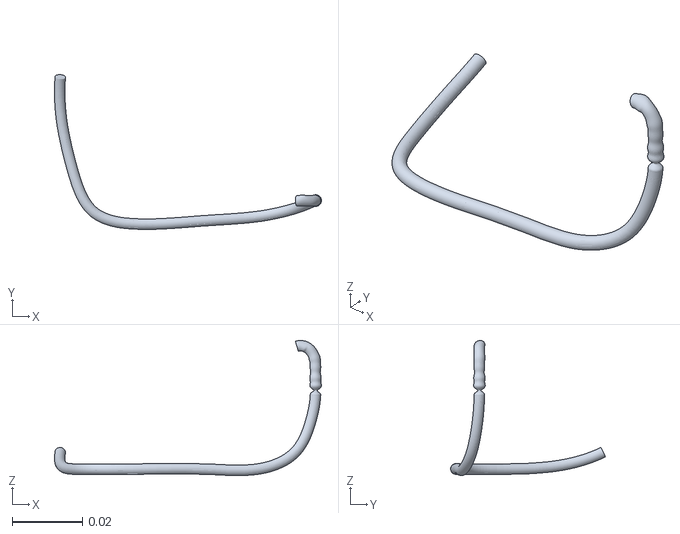
[picture p62: CAD file, 2026-10-11]
juan/assets/usb_c_power_cable__regulator_to_pi.stl
0.0762 x 0.0442 x 0.0385
