Iva5858/juan_learns_to_walk/juan/assets/lead_in_from_the_thigh_to_the_ankle_servo__left.stl

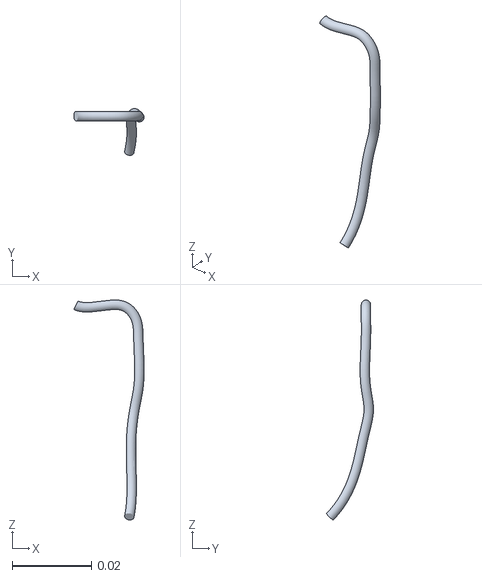
[picture p63: CAD file, 2026-10-11]
juan/assets/lead_in_from_the_thigh_to_the_ankle_servo__left.stl
0.0178 x 0.0119 x 0.0557
