Iva5858/juan_learns_to_walk/juan/assets/lm2596_regulator__11.stl

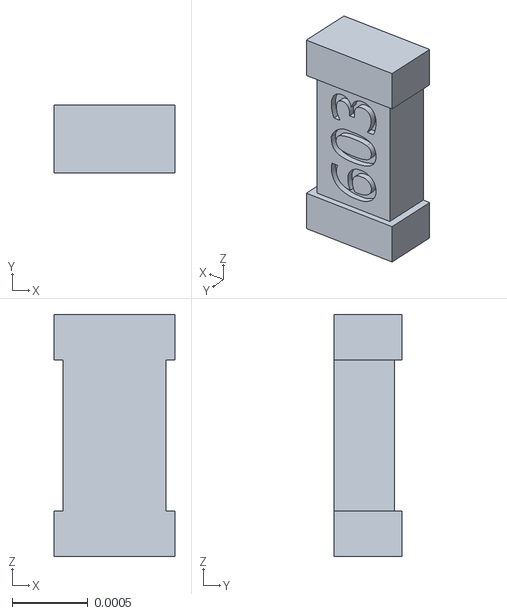
[picture p64: CAD file, 2026-10-11]
juan/assets/lm2596_regulator__11.stl
0.0008 x 0.00045 x 0.0016
