Iva5858/juan_learns_to_walk/juan/assets/servo_bus_lead__left_leg.stl

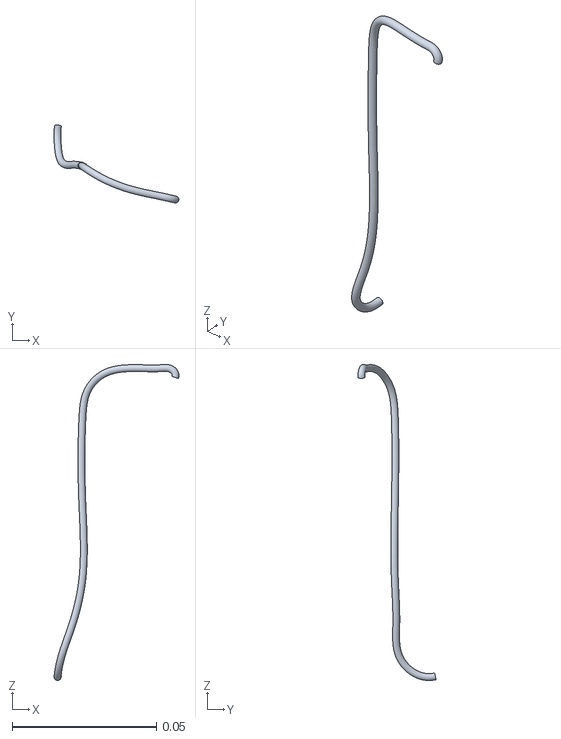
[picture p65: CAD file, 2026-10-11]
juan/assets/servo_bus_lead__left_leg.stl
0.0433 x 0.027 x 0.11
