Iva5858/juan_learns_to_walk/juan/assets/adafruit_bno055_imu__45.stl

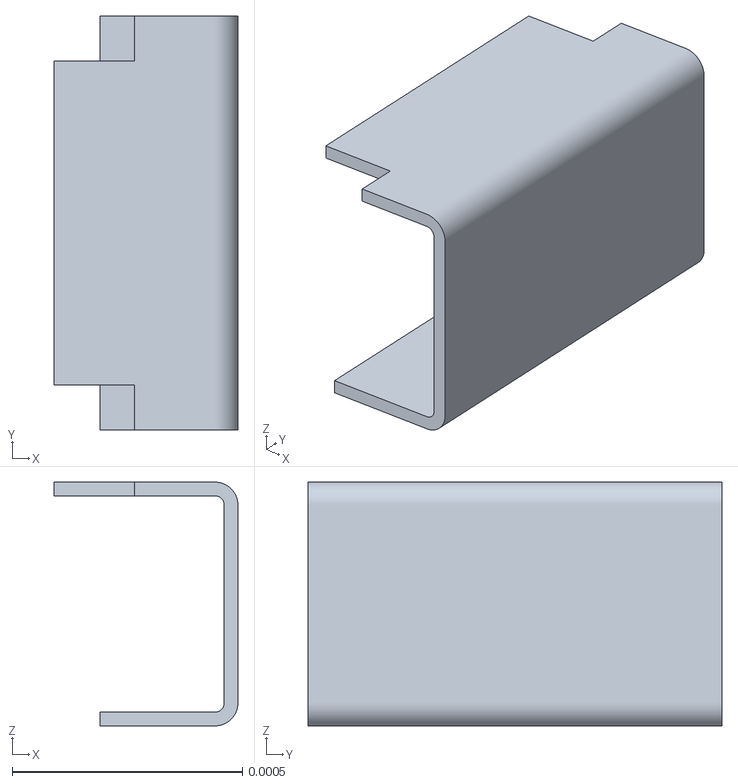
[picture p66: CAD file, 2026-10-11]
juan/assets/adafruit_bno055_imu__45.stl
0.0004 x 0.0009 x 0.00053
