Iva5858/juan_learns_to_walk/juan/assets/usb_socket.stl

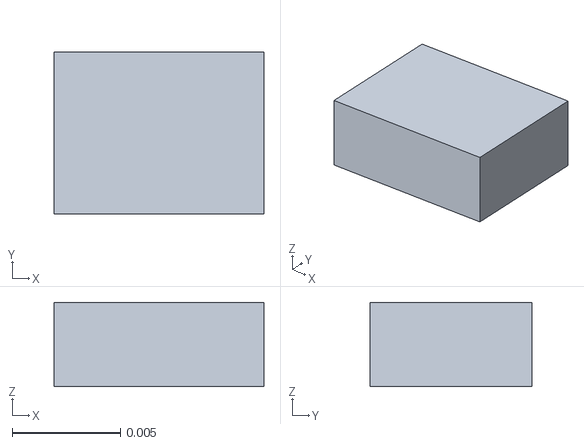
[picture p67: CAD file, 2026-10-11]
juan/assets/usb_socket.stl
0.0097 x 0.0075 x 0.0039
