Iva5858/juan_learns_to_walk/juan/assets/pi_battery_leads_to_regulator__2_wires__drawn_as_one.stl

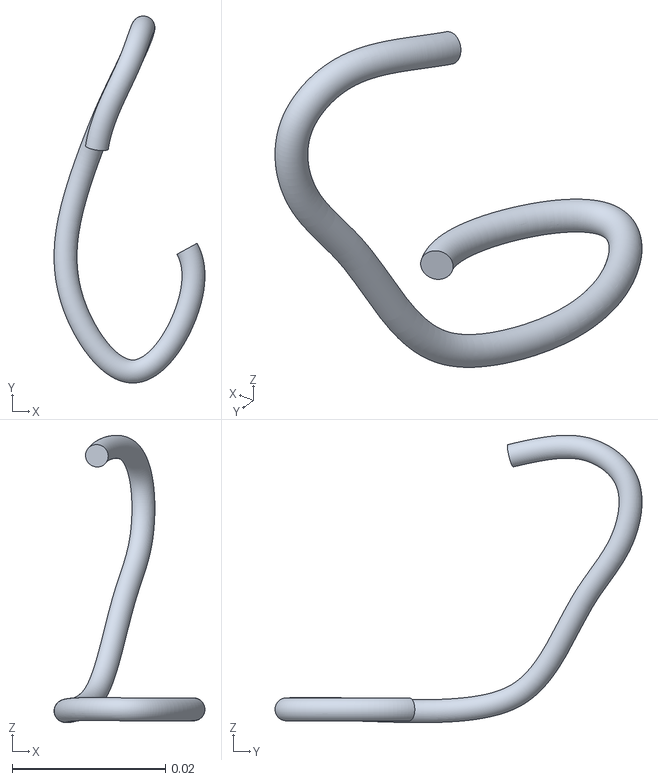
[picture p68: CAD file, 2026-10-11]
juan/assets/pi_battery_leads_to_regulator__2_wires__drawn_as_one.stl
0.0197 x 0.0478 x 0.0375
