Iva5858/juan_learns_to_walk/juan/assets/servo_socket_a.stl

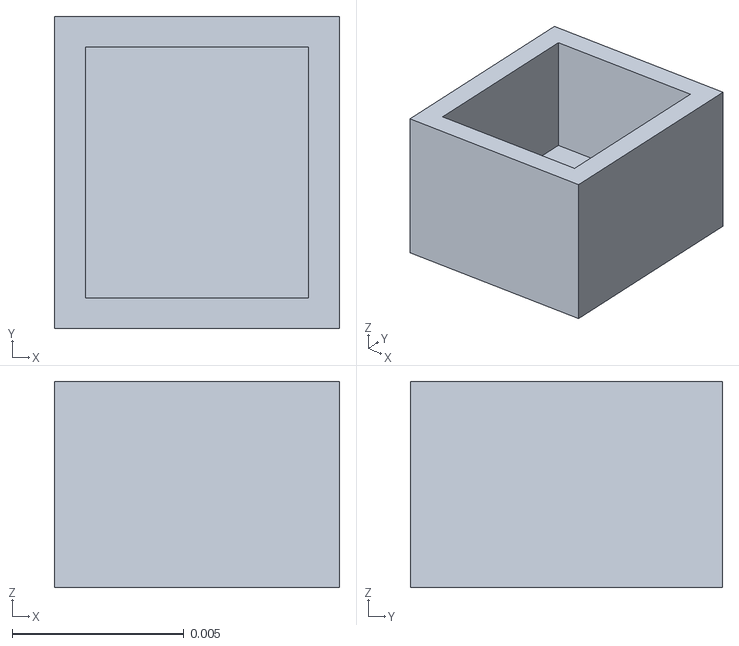
[picture p69: CAD file, 2026-10-11]
juan/assets/servo_socket_a.stl
0.0083 x 0.0091 x 0.006
