Iva5858/juan_learns_to_walk/juan/assets/htd_35h_servo_body.stl

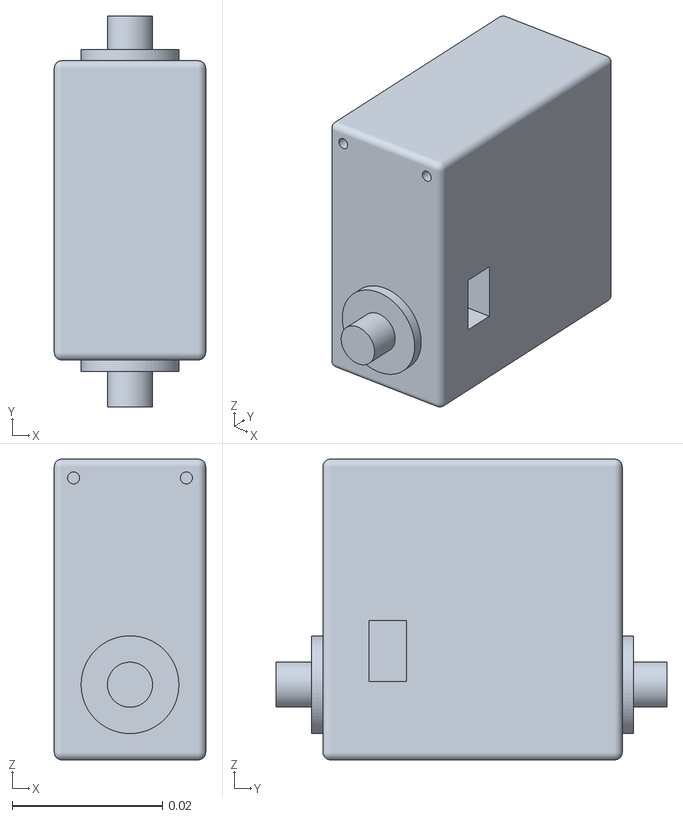
[picture p70: CAD file, 2026-10-11]
juan/assets/htd_35h_servo_body.stl
0.0202 x 0.052 x 0.04
