Iva5858/juan_learns_to_walk/juan/assets/adafruit_bno055_imu__55.stl

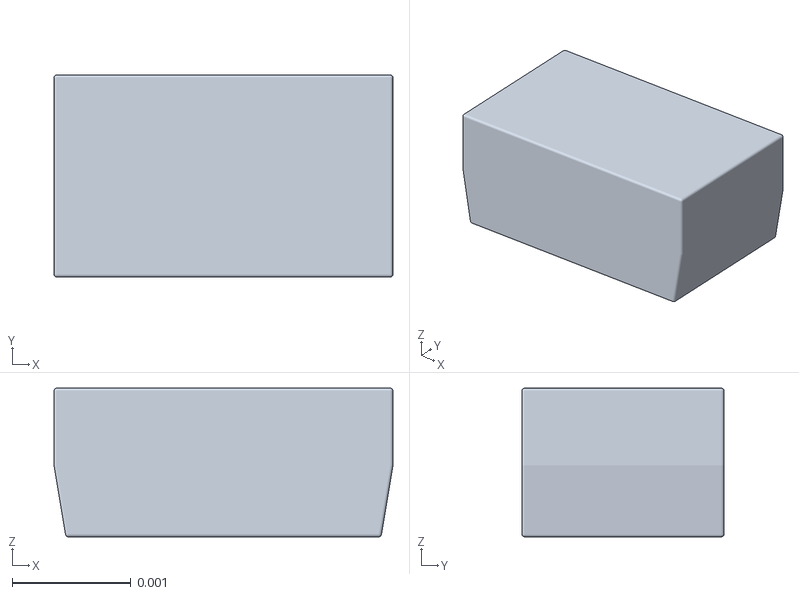
[picture p71: CAD file, 2026-10-11]
juan/assets/adafruit_bno055_imu__55.stl
0.00285 x 0.0017 x 0.00125
