Iva5858/juan_learns_to_walk/juan/assets/chip_1.stl

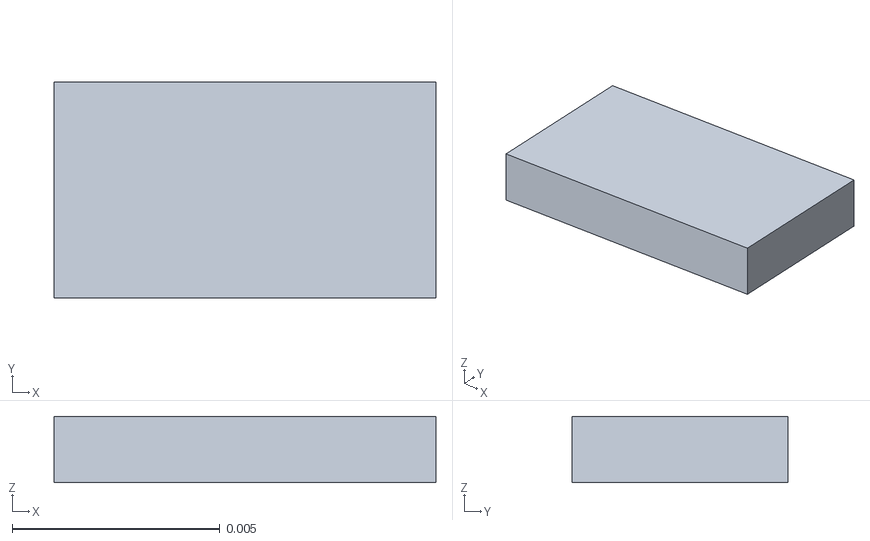
[picture p72: CAD file, 2026-10-11]
juan/assets/chip_1.stl
0.0092 x 0.0052 x 0.0016
