Iva5858/juan_learns_to_walk/juan/assets/adafruit_bno055_imu__74.stl

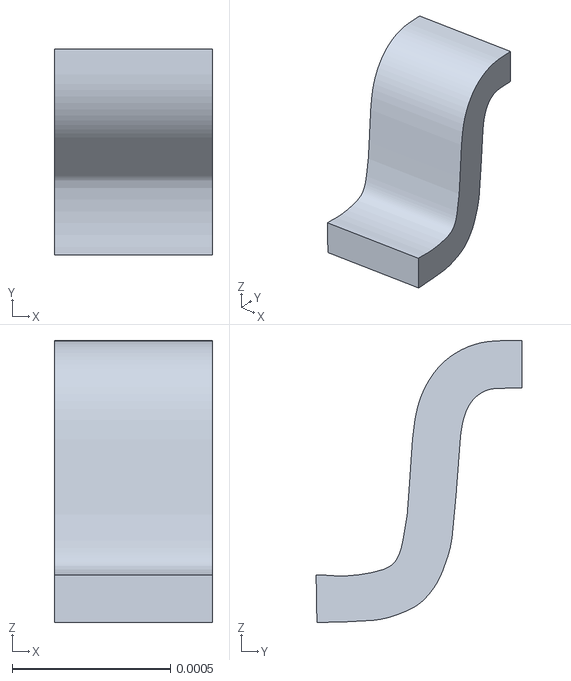
[picture p73: CAD file, 2026-10-11]
juan/assets/adafruit_bno055_imu__74.stl
0.0005 x 0.00065 x 0.00089
