Iva5858/juan_learns_to_walk/juan/assets/trunk_lead_into_the_roll_servo__left.stl

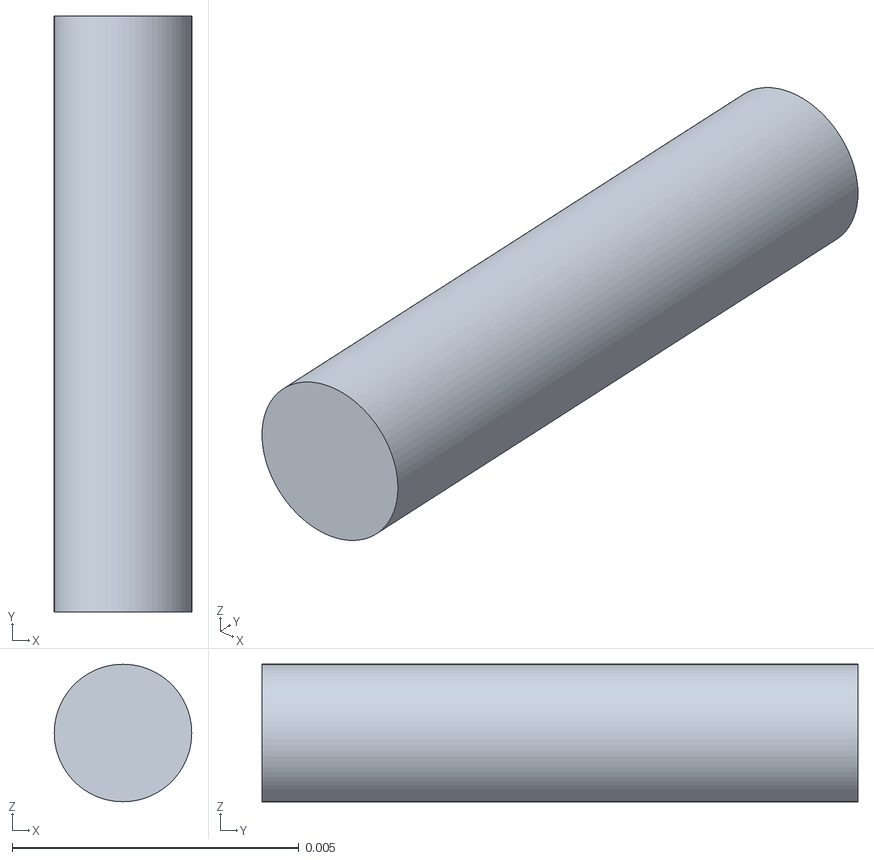
[picture p74: CAD file, 2026-10-11]
juan/assets/trunk_lead_into_the_roll_servo__left.stl
0.0024 x 0.0104 x 0.0024
