Iva5858/juan_learns_to_walk/juan/assets/circuit_board_40_x_25.stl

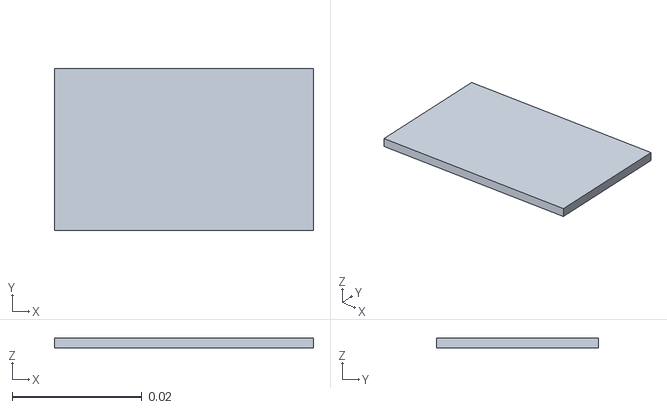
[picture p75: CAD file, 2026-10-11]
juan/assets/circuit_board_40_x_25.stl
0.04 x 0.025 x 0.0016
