Iva5858/juan_learns_to_walk/juan/assets/usb_c_plug.stl

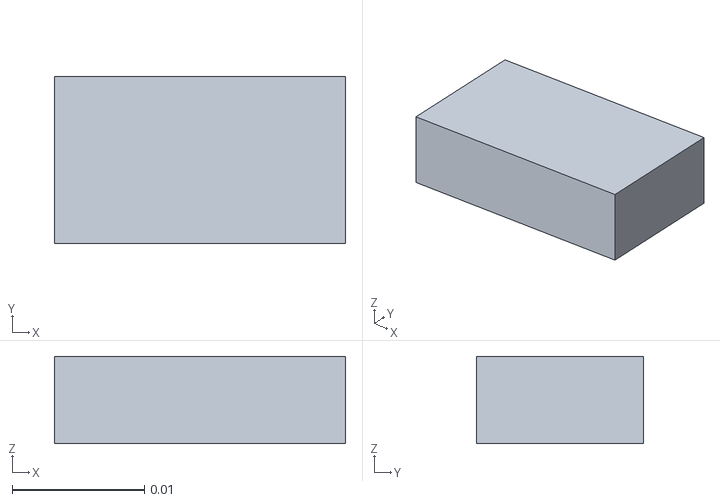
[picture p76: CAD file, 2026-10-11]
juan/assets/usb_c_plug.stl
0.022 x 0.0126 x 0.0066
