Iva5858/juan_learns_to_walk/juan/assets/lm2596_regulator__6.stl

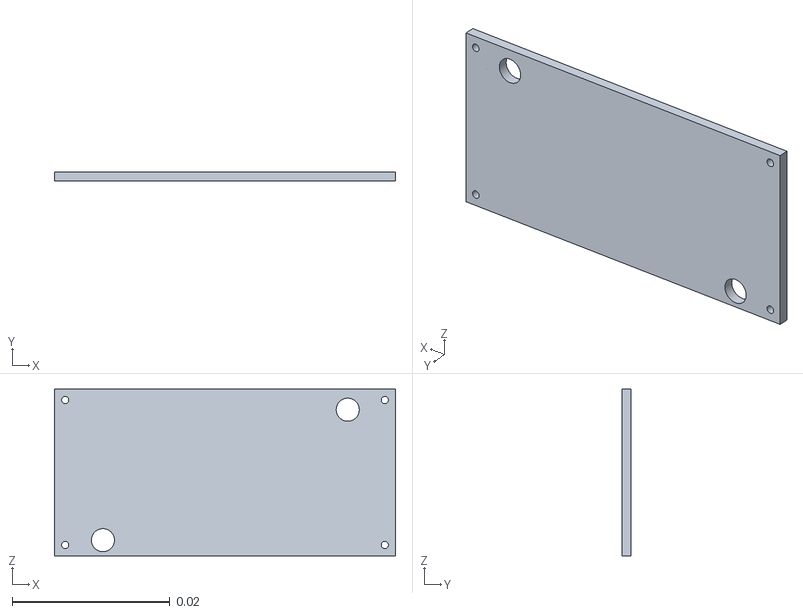
[picture p77: CAD file, 2026-10-11]
juan/assets/lm2596_regulator__6.stl
0.0432 x 0.0012 x 0.0211
