Iva5858/juan_learns_to_walk/juan/assets/vin_jumper.stl

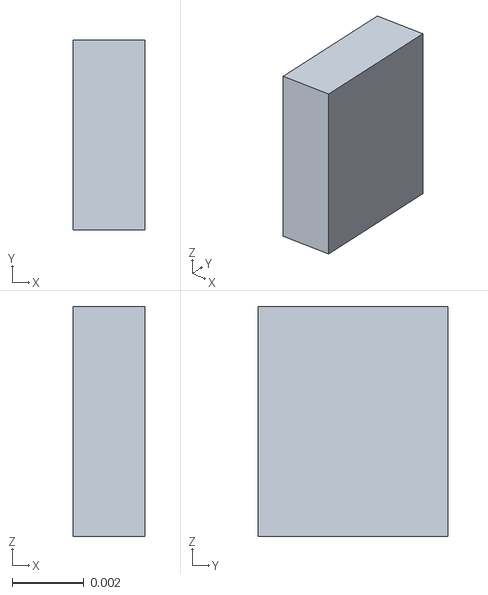
[picture p78: CAD file, 2026-10-11]
juan/assets/vin_jumper.stl
0.002 x 0.0053 x 0.0064
