Iva5858/juan_learns_to_walk/juan/assets/serial_port.stl

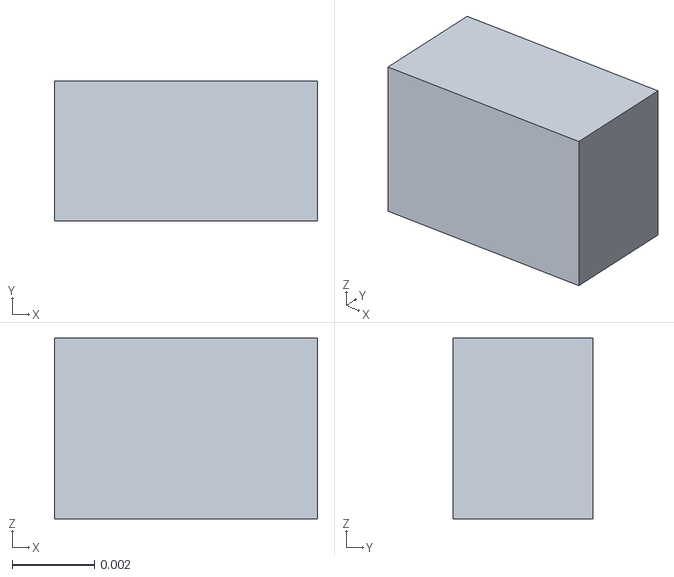
[picture p79: CAD file, 2026-10-11]
juan/assets/serial_port.stl
0.0064 x 0.0034 x 0.0044
