Iva5858/juan_learns_to_walk/juan/assets/5_pelvis.stl

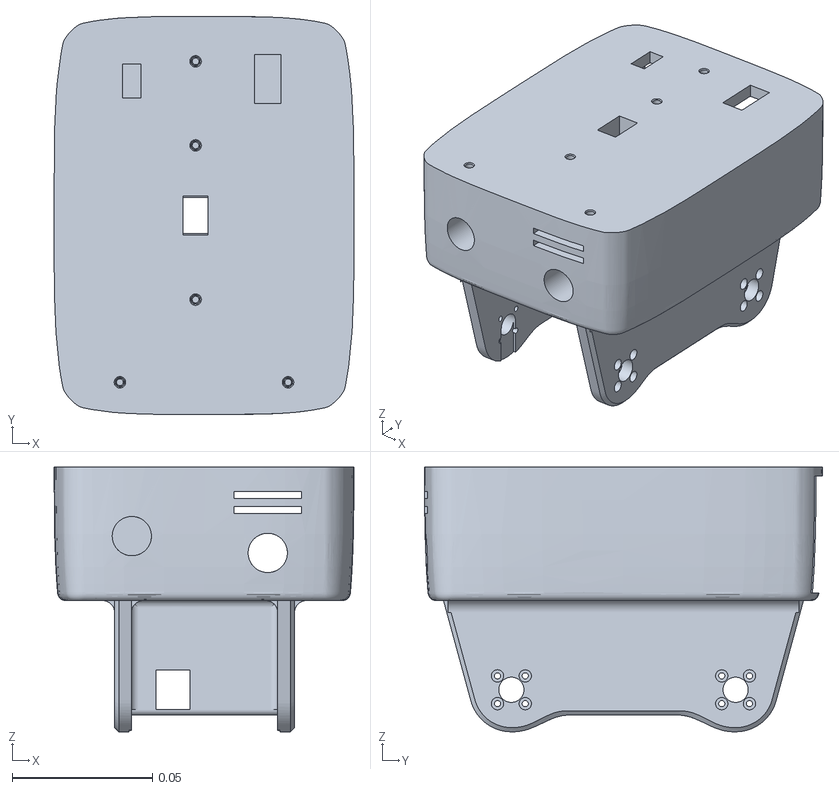
[picture p80: CAD file, 2026-10-11]
juan/assets/5_pelvis.stl
0.107 x 0.142 x 0.0944
