Iva5858/juan_learns_to_walk/juan/assets/6_battery_door.stl

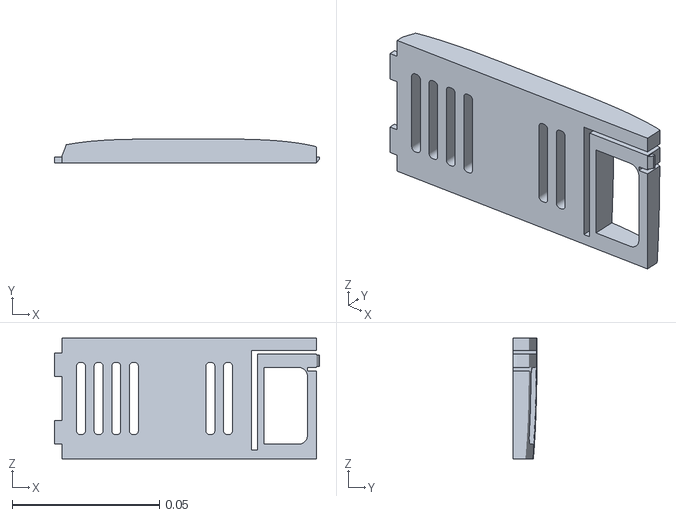
[picture p81: CAD file, 2026-10-11]
juan/assets/6_battery_door.stl
0.0901 x 0.0082 x 0.0411
