Iva5858/juan_learns_to_walk/juan/assets/lm2596_regulator__19.stl

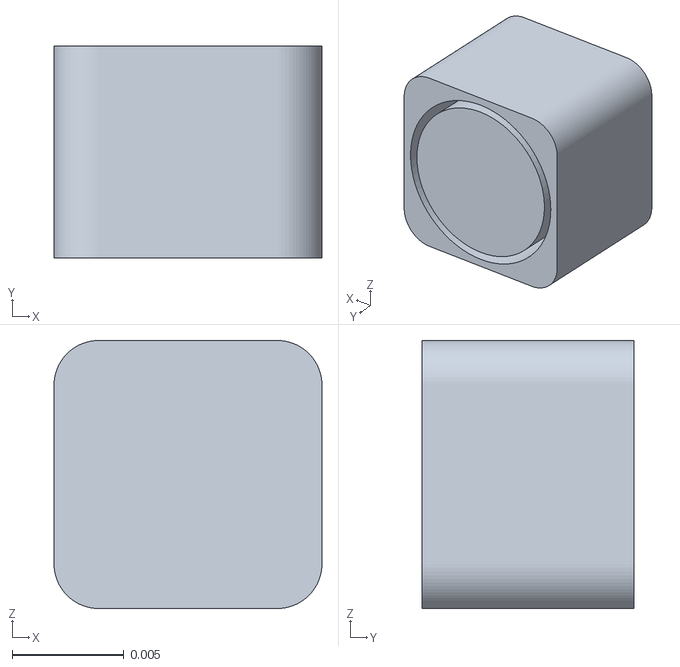
[picture p82: CAD file, 2026-10-11]
juan/assets/lm2596_regulator__19.stl
0.012 x 0.0095 x 0.012
