Iva5858/juan_learns_to_walk/juan/assets/7_head_tray.stl

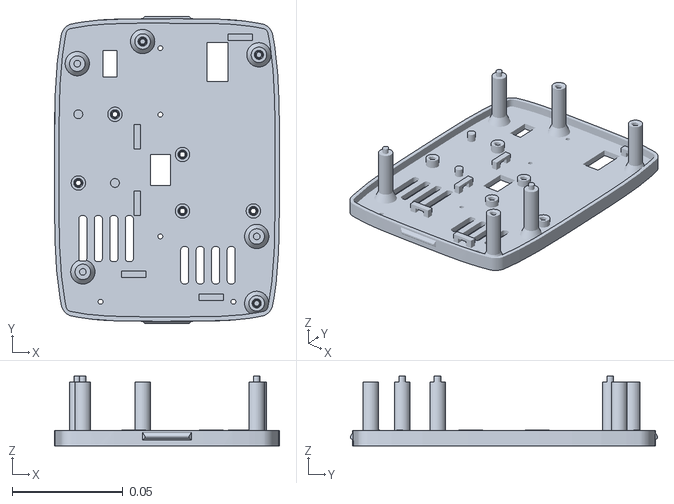
[picture p83: CAD file, 2026-10-11]
juan/assets/7_head_tray.stl
0.102 x 0.139 x 0.0316
