Iva5858/juan_learns_to_walk/juan/assets/adafruit_bno055_imu__3.stl

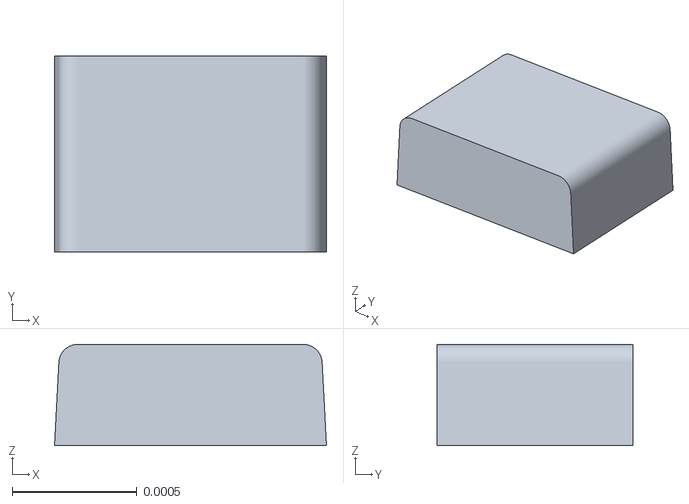
[picture p84: CAD file, 2026-10-11]
juan/assets/adafruit_bno055_imu__3.stl
0.00109 x 0.000787 x 0.000406
