Iva5858/juan_learns_to_walk/juan/assets/pi_camera_v2_1.stl

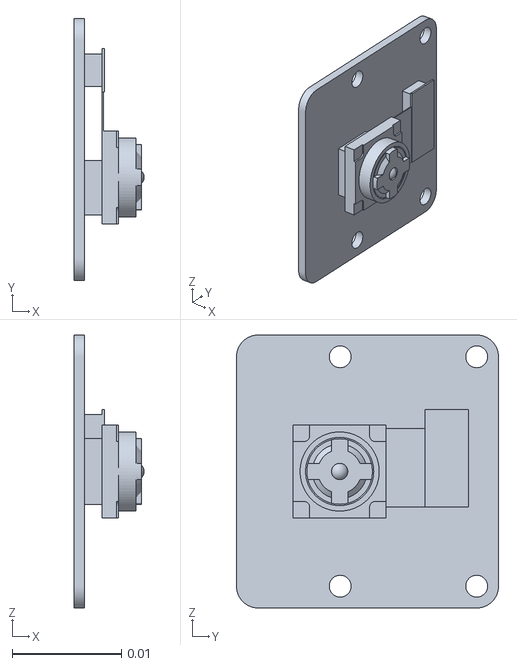
[picture p85: CAD file, 2026-10-11]
juan/assets/pi_camera_v2_1.stl
0.00645 x 0.024 x 0.025
