Iva5858/juan_learns_to_walk/juan/assets/2a_thigh_inboard_mirrored.stl

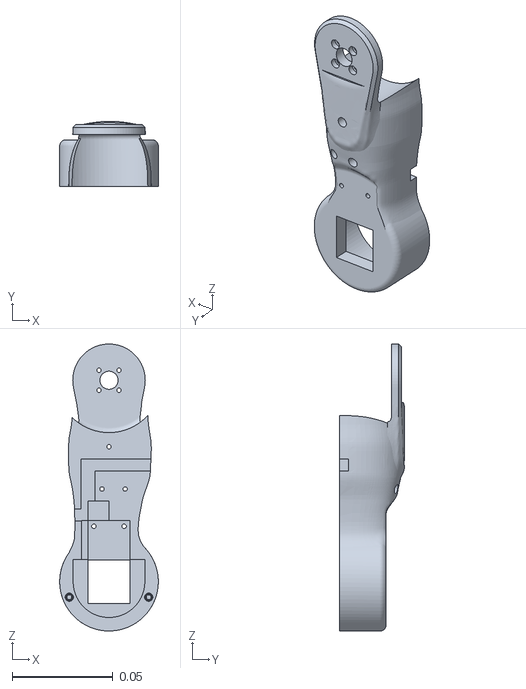
[picture p86: CAD file, 2026-10-11]
juan/assets/2a_thigh_inboard_mirrored.stl
0.049 x 0.0324 x 0.142
