Iva5858/juan_learns_to_walk/juan/assets/xt30_pair.stl

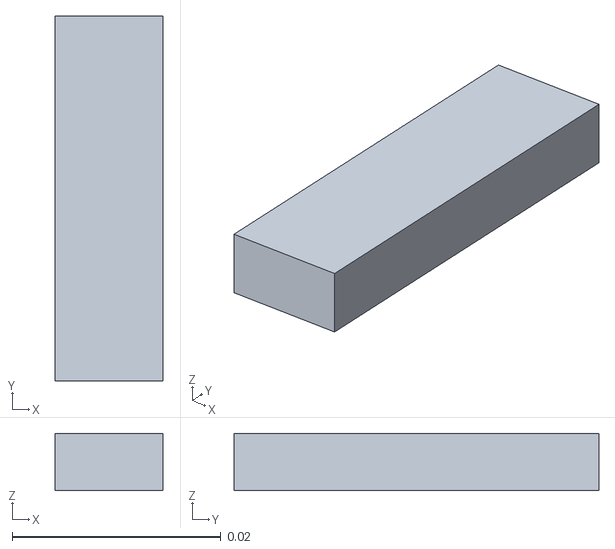
[picture p87: CAD file, 2026-10-11]
juan/assets/xt30_pair.stl
0.0104 x 0.035 x 0.0055
