Iva5858/juan_learns_to_walk/juan/assets/debug_board_holder__buslinker_case_v2__usb_corner_opened.stl

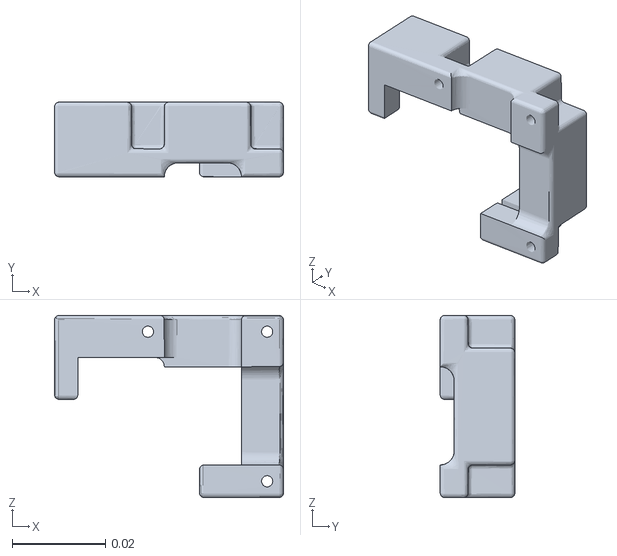
[picture p88: CAD file, 2026-10-11]
juan/assets/debug_board_holder__buslinker_case_v2__usb_corner_opened.stl
0.049 x 0.016 x 0.039
