Iva5858/juan_learns_to_walk/juan/assets/adafruit_bno055_imu__19.stl

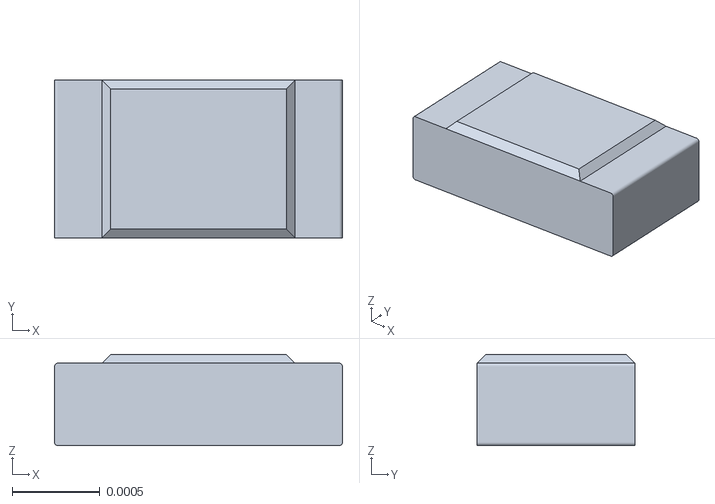
[picture p89: CAD file, 2026-10-11]
juan/assets/adafruit_bno055_imu__19.stl
0.00164 x 0.0009 x 0.00052
