Iva5858/juan_learns_to_walk/juan/assets/battery_3s_650_mah__pi.stl

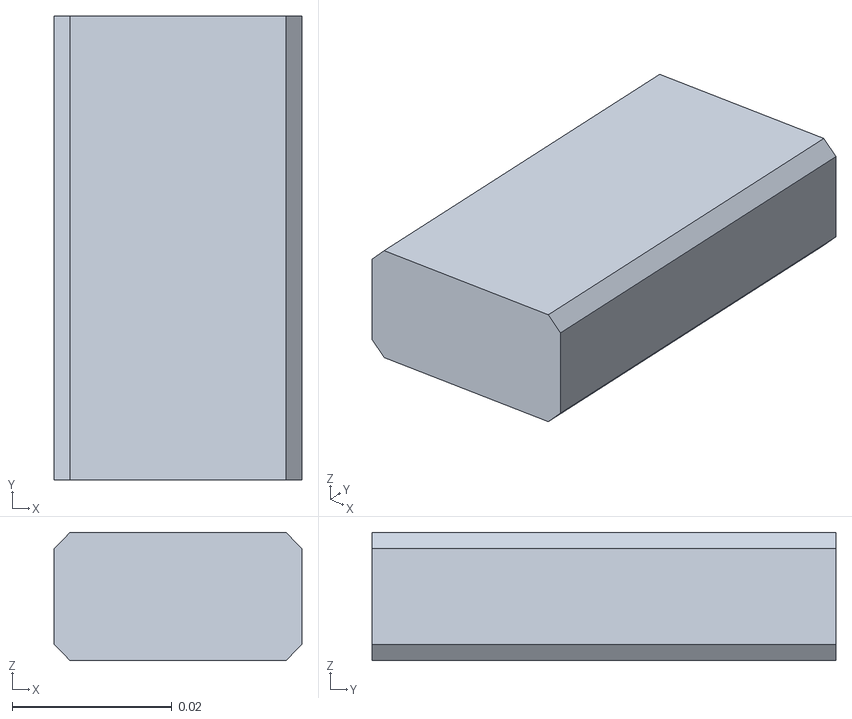
[picture p90: CAD file, 2026-10-11]
juan/assets/battery_3s_650_mah__pi.stl
0.031 x 0.058 x 0.016
