Iva5858/juan_learns_to_walk/(list of files, cad)

Other CAD files:
juan/assets/1a_hip_inboard_mirrored.stl
juan/assets/3b_shin_outboard.stl
juan/assets/adafruit_bno055_imu__38.stl
juan/assets/adafruit_bno055_imu__24.stl
juan/assets/adafruit_bno055_imu__31.stl
juan/assets/adafruit_bno055_imu__14.stl
juan/assets/adafruit_bno055_imu__33.stl
juan/assets/adafruit_bno055_imu__58.stl
juan/assets/lead__knee_servo_out_to_the_shin__left.stl
juan/assets/adafruit_bno055_imu__46.stl
juan/assets/adafruit_bno055_imu__73.stl
juan/assets/adafruit_bno055_imu__48.stl
juan/assets/adafruit_bno055_imu__44.stl
juan/assets/adafruit_bno055_imu__23.stl
juan/assets/adafruit_bno055_imu__50.stl
juan/assets/adafruit_bno055_imu__32.stl
juan/assets/adafruit_bno055_imu__26.stl
juan/assets/adafruit_bno055_imu__25.stl
juan/assets/adafruit_bno055_imu__83.stl
juan/assets/adafruit_bno055_imu__2.stl
juan/assets/1a_hip_inboard.stl
juan/assets/adafruit_bno055_imu__53.stl
juan/assets/adafruit_bno055_imu__28.stl
juan/assets/adafruit_bno055_imu__43.stl
juan/assets/adafruit_bno055_imu__11.stl
juan/assets/adafruit_bno055_imu__42.stl
juan/assets/lead_in_from_the_hip_to_the_knee_servo__right.stl
juan/assets/adafruit_bno055_imu__76.stl
juan/assets/lm2596_regulator__7.stl
juan/assets/adafruit_bno055_imu__49.stl
juan/assets/adafruit_bno055_imu__13.stl
juan/assets/adafruit_bno055_imu__41.stl
juan/assets/adafruit_bno055_imu__16.stl
juan/assets/adafruit_bno055_imu__62.stl
juan/assets/adafruit_bno055_imu__18.stl
juan/assets/lm2596_regulator__4.stl
juan/assets/adafruit_bno055_imu__60.stl
juan/assets/adafruit_bno055_imu__10.stl
juan/assets/lead_in_from_the_thigh_to_the_ankle_servo__right.stl
juan/assets/1b_hip_outboard_mirrored.stl
juan/assets/adafruit_bno055_imu__22.stl
juan/assets/lm2596_regulator__20.stl
juan/assets/lead__hip_pitch_servo_out_to_the_thigh__left.stl
juan/assets/lm2596_regulator__25.stl
juan/assets/adafruit_bno055_imu__17.stl
juan/assets/lead__roll_servo_to_hip_pitch_servo__right.stl
juan/assets/servo_plug_a.stl
juan/assets/lm2596_regulator.stl
juan/assets/trunk_lead_into_the_roll_servo__right.stl
juan/assets/adafruit_bno055_imu__57.stl
juan/assets/2b_thigh_outboard_mirrored.stl
juan/assets/adafruit_bno055_imu__59.stl
juan/assets/adafruit_bno055_imu__40.stl
juan/assets/adafruit_bno055_imu__67.stl
juan/assets/adafruit_bno055_imu__78.stl
juan/assets/lm2596_regulator__22.stl
juan/assets/adafruit_bno055_imu__64.stl
juan/assets/3a_shin_inboard_mirrored.stl
juan/assets/4_ankle_foot_mirrored.stl
juan/assets/adafruit_bno055_imu__15.stl
juan/assets/2a_thigh_inboard.stl
juan/assets/adafruit_bno055_imu__20.stl
juan/assets/adafruit_bno055_imu__30.stl
juan/assets/adafruit_bno055_imu__34.stl
juan/assets/adafruit_bno055_imu__36.stl
juan/assets/adafruit_bno055_imu__47.stl
juan/assets/adafruit_bno055_imu__6.stl
juan/assets/adafruit_bno055_imu__61.stl
juan/assets/adafruit_bno055_imu__65.stl
juan/assets/adafruit_bno055_imu__7.stl
juan/assets/adafruit_bno055_imu__75.stl
juan/assets/adafruit_bno055_imu__8.stl
juan/assets/adafruit_bno055_imu__80.stl
juan/assets/adafruit_bno055_imu__84.stl
juan/assets/capacitor_100_uf.stl
juan/assets/lm2596_regulator__16.stl
juan/assets/lm2596_regulator__17.stl
juan/assets/lm2596_regulator__21.stl
juan/assets/m2_heat_set_insert.stl
juan/assets/m2_x_12_socket_head_screw.stl
juan/assets/m2_x_5_horn_screw__servo_bag.stl
juan/assets/m2_x_8_socket_head_screw.stl
juan/assets/motor_battery_leads_to_the_debug_board_s_screw_terminal__2_wires__drawn_as_one.stl
juan/assets/raspberry_pi_4_model_b__block_model.stl
juan/assets/screw_terminal__battery_in.stl
juan/assets/xt60_pair.stl
