Iva5858/juan_learns_to_walk/juan/rl_robot.xml

<mujoco model="juan">
  <compiler angle="radian" meshdir="assets" autolimits="true" inertiafromgeom="true" />
  <option timestep="0.002" integrator="implicitfast" />
  <default>
    <default class="juan">
      <joint frictionloss="0.02" armature="0.001" damping="0.02" />
      <position kp="50" dampratio="1" />
      <default class="visual">
        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
      </default>
      <default class="collision">
        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
      </default>
    </default>
  </default>
  <worldbody>
    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
    <body name="body" pos="0 0 0" quat="1 0 0 0" childclass="juan">
      <freejoint name="body_freejoint" />
      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
      <body name="left_hip_link" pos="-0.02615 0.0398476 0.281375" quat="0 0.707107 -0 0.707107">
        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
        <joint axis="0 0 1" name="left_hip_roll" type="hinge" range="-0.0872665 0.436332" />
        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
        <body name="left_thigh_link" pos="-0.049375 0.01615 0.02615" quat="0.5 -0.5 -0.5 -0.5">
          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
          <joint axis="-0 -0 -1" name="left_hip_pitch" type="hinge" range="-1.5708 0.436332" />
          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
          <body name="left_shin_link" pos="-0 -0.1 -0" quat="1 -0 0 -0">
            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
            <joint axis="-0 -0 -1" name="left_knee" type="hinge" range="-0.349066 1.74533" />
            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
            <body name="left_foot_link" pos="-0 -0.1 0" quat="1 -0 -0 0">
              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
              <joint axis="-0 -0 -1" name="left_ankle" type="hinge" range="-1.0472 1.5708" />
              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
            </body>
            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
          </body>
          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
        </body>
      </body>
      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
      <body name="right_hip_link" pos="-0.02615 -0.0401524 0.281375" quat="0 -0.707107 0 0.707107">
        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
        <joint axis="-0 -0 -1" name="right_hip_roll" type="hinge" range="-0.436332 0.0872665" />
        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
        <body name="right_thigh_link" pos="0.049375 0.03585 -0.02615" quat="0.5 -0.5 -0.5 -0.5">
          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
          <joint axis="-0 -0 -1" name="right_hip_pitch" type="hinge" range="-1.5708 0.436332" />
          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
          <body name="right_shin_link" pos="-0 0.1 -0.0007" quat="1 -0 -0 0">
            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
            <joint axis="-0 -0 -1" name="right_knee" type="hinge" range="-0.349066 1.74533" />
            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
            <body name="right_foot_link" pos="-0 0.1 -0.0527" quat="0 1 -0 0">
              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
              <joint axis="0 0 1" name="right_ankle" type="hinge" range="-1.0471975511965248 1.5707963267949694" />
              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
            </body>
            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
          </body>
          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
        </body>
      </body>
      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
    </body>
  </worldbody>
  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
  <actuator>
    <position name="left_hip_roll" joint="left_hip_roll" kp="15" inheritrange="1" forcerange="-3.43 3.43" />
    <position name="left_hip_pitch" joint="left_hip_pitch" kp="15" inheritrange="1" forcerange="-3.43 3.43" />
    <position name="left_knee" joint="left_knee" kp="15" inheritrange="1" forcerange="-3.43 3.43" />
    <position name="left_ankle" joint="left_ankle" kp="15" inheritrange="1" forcerange="-3.43 3.43" />
    <position name="right_hip_roll" joint="right_hip_roll" kp="15" inheritrange="1" forcerange="-3.43 3.43" />
    <position name="right_hip_pitch" joint="right_hip_pitch" kp="15" inheritrange="1" forcerange="-3.43 3.43" />
    <position name="right_knee" joint="right_knee" kp="15" inheritrange="1" forcerange="-3.43 3.43" />
    <position name="right_ankle" joint="right_ankle" kp="15" inheritrange="1" forcerange="-3.43 3.43" />
  </actuator>
  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
</mujoco>
