Iva5858/juan_learns_to_walk/juan/robot.xml

<?xml version="1.0" ?>
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
<mujoco model="juan">
  <compiler angle="radian" meshdir="assets" autolimits="true"/>
  <default>
    <default class="juan">
      <joint frictionloss="0.1" armature="0.005"/>
      <position kp="50" dampratio="1"/>
      <default class="visual">
        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
      </default>
      <default class="collision">
        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
      </default>
    </default>
  </default>
  <worldbody>
    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
    <body name="body" pos="0 0 0" quat="1 0 0 0" childclass="juan">
      <freejoint name="body_freejoint"/>
      <inertial pos="0 0 0" mass="1e-09" fullinertia="1e-09 1e-09 1e-09 0 0 0"/>
      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
      <body name="left_hip_link" pos="-0.02615 0.0398476 0.281375" quat="0 0.707107 -0 0.707107">
        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
        <joint axis="0 0 1" name="left_hip_roll" type="hinge"/>
        <inertial pos="0 0 0" mass="1e-09" fullinertia="1e-09 1e-09 1e-09 0 0 0"/>
        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
        <body name="left_thigh_link" pos="-0.049375 0.01615 0.02615" quat="0.5 -0.5 -0.5 -0.5">
          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
          <joint axis="0 0 1" name="left_hip_pitch" type="hinge" range="-0.4363323129981516 1.5707963267953273"/>
          <inertial pos="0 0 0" mass="1e-09" fullinertia="1e-09 1e-09 1e-09 0 0 0"/>
          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
          <body name="left_shin_link" pos="-0 -0.1 -0" quat="1 -0 0 -0">
            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
            <joint axis="0 0 1" name="left_knee" type="hinge" range="-1.7453292519942905 0.349065850398905"/>
            <inertial pos="0 0 0" mass="1e-09" fullinertia="1e-09 1e-09 1e-09 0 0 0"/>
            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
            <body name="left_foot_link" pos="-0 -0.1 0" quat="1 -0 -0 0">
              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
              <joint axis="0 0 1" name="left_ankle" type="hinge" range="-1.5707963267948548 1.0471975511966394"/>
              <inertial pos="0 0 0" mass="1e-09" fullinertia="1e-09 1e-09 1e-09 0 0 0"/>
              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
            </body>
          </body>
        </body>
      </body>
      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
      <body name="right_hip_link" pos="-0.02615 -0.0401524 0.281375" quat="0 -0.707107 0 0.707107">
        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
        <joint axis="0 0 1" name="right_hip_roll" type="hinge"/>
        <inertial pos="0 0 0" mass="1e-09" fullinertia="1e-09 1e-09 1e-09 0 0 0"/>
        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
        <body name="right_thigh_link" pos="0.049375 0.03585 -0.02615" quat="0.5 -0.5 -0.5 -0.5">
          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
          <joint axis="0 0 1" name="right_hip_pitch" type="hinge" range="-0.4363323129983941 1.5707963267950849"/>
          <inertial pos="0 0 0" mass="1e-09" fullinertia="1e-09 1e-09 1e-09 0 0 0"/>
          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
          <body name="right_shin_link" pos="-0 0.1 -0.0007" quat="1 -0 -0 0">
            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
            <joint axis="0 0 1" name="right_knee" type="hinge" range="-1.7453292519941945 0.3490658503990009"/>
            <inertial pos="0 0 0" mass="1e-09" fullinertia="1e-09 1e-09 1e-09 0 0 0"/>
            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
            <body name="right_foot_link" pos="-0 0.1 -0.0527" quat="0 1 -0 0">
              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
              <joint axis="0 0 1" name="right_ankle" type="hinge" range="-1.0471975511965248 1.5707963267949694"/>
              <inertial pos="0 0 0" mass="1e-09" fullinertia="1e-09 1e-09 1e-09 0 0 0"/>
              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
            </body>
          </body>
        </body>
      </body>
    </body>
  </worldbody>
  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
  <actuator>
    <position class="juan" name="left_hip_roll" joint="left_hip_roll"/>
    <position class="juan" name="left_hip_pitch" joint="left_hip_pitch" inheritrange="1"/>
    <position class="juan" name="left_knee" joint="left_knee" inheritrange="1"/>
    <position class="juan" name="left_ankle" joint="left_ankle" inheritrange="1"/>
    <position class="juan" name="right_hip_roll" joint="right_hip_roll"/>
    <position class="juan" name="right_hip_pitch" joint="right_hip_pitch" inheritrange="1"/>
    <position class="juan" name="right_knee" joint="right_knee" inheritrange="1"/>
    <position class="juan" name="right_ankle" joint="right_ankle" inheritrange="1"/>
  </actuator>
  <equality/>
</mujoco>
