Iva5858/juan_learns_to_walk/(commit log)

2026-10-11 Snapshot before v7: juan_v3 is still the preferred walker
    [1a_hip_inboard.stl, 1a_hip_inboard_mirrored.stl, 1b_hip_outboard.stl, 1b_hip_outboard_mirrored.stl, 2a_thigh_inboard.stl, 2a_thigh_inboard_mirrored.stl, 2b_thigh_outboard.stl, 2b_thigh_outboard_mirrored.stl]
2026-10-11 Portable model paths, add fall and joint breakdown tools
2026-10-11 Better physics realism: mass to 2.25 kg, 5-59 ms delay, gear slack, servo calibration, IMU bias, voltage coupling, load-aware hardware stop
2026-10-11 v7 recipe: juan_v3 rewards, per-direction push curriculum, staged training script
2026-10-12 Rewrite README for the current project
2026-10-12 Fix difficulty gate (key name); run it before stage 4 so the script resumes correctly
2026-10-12 Varied starting states (perturbed crouch, moving body), on from the physics stage
2026-10-12 Restructure like Berkeley Humanoid Lite: robots/, tasks/locomotion (env, env_cfg, mdp terms), training/, scripts/; installable package
    Code organization follows Berkeley Humanoid Lite: Y. Chi, Q. Liao, J. Long, X. Huang, S. Shao, B. Nikolic, Z. Li, K. Sreenath, "Demonstrating Berkeley Humanoid Lite: An Open-source, Accessible, and Customizable 3D-printed Humanoid Robot", arXiv:2504.17249, 2025. https://github.com/HybridRobotics/Berkeley-Humanoid-Lite
    Behaviour unchanged: the environment reproduces the previous version bit for bit (observations, rewards, terminations, curricula, rendered frames).
2026-10-14 train.py: --command overrides; overrides applied after --stage; backward-speed chart
2026-10-15 Bench-based servo timing: at least 1 step of action delay; --robot / --randomization overrides
2026-10-23 Run the policy on the robot: numpy export checked against the sim, LSM9DS1 + gravity filter, 50 Hz walker with safety stops and logs, dashboard steering
2026-10-24 v7_10: policies re-trained on the measured servos (10a: straightest; 10b best: most push-robust)
2026-10-24 v7_10 policies on measured servos; heading error capped below the wrap; fall test copies the servo model
    [policy.py]
2026-10-24 v7_11 upright: standing lean -8 deg -> +1.5 deg, push survival 17 -> 19/30 (measured servos)
2026-10-24 IMU: 4 Hz low-pass on the gyro the policy sees (servo buzz caused 16-18 Hz chatter); vibration gauge
    [imu.py]
2026-10-24 v7_12a: trained with 45-79 ms delay, gyro buzz + 4 Hz filter, upright terms; training workers skip visual meshes (2 GB -> 0.1 GB, physics identical)
2026-10-25 Code pass: regroup config, merge duplicated helpers, drop unused code, finetune.sh; export check uses the trained servo delay; v7_13 straight policy
